michaelmargolis/MirtoDesignFiles/README.md

# MirtoDesignFiles

Design files for Mirto Robots

Mirto_Hubee robot has a Teensy3 controller driving HUBee wheels 

Mirto_Hotec has a teensy3 controller driving Hotec motors

Mirto_MyRio uses National Instruments myRIO to control Hotec Motors.
