michaelmargolis/MirtoDesignFiles/Mirto_Hotec/Multi-build dxf files/MirtoAcrylicChassis_6_off_ FullSheet.dxf

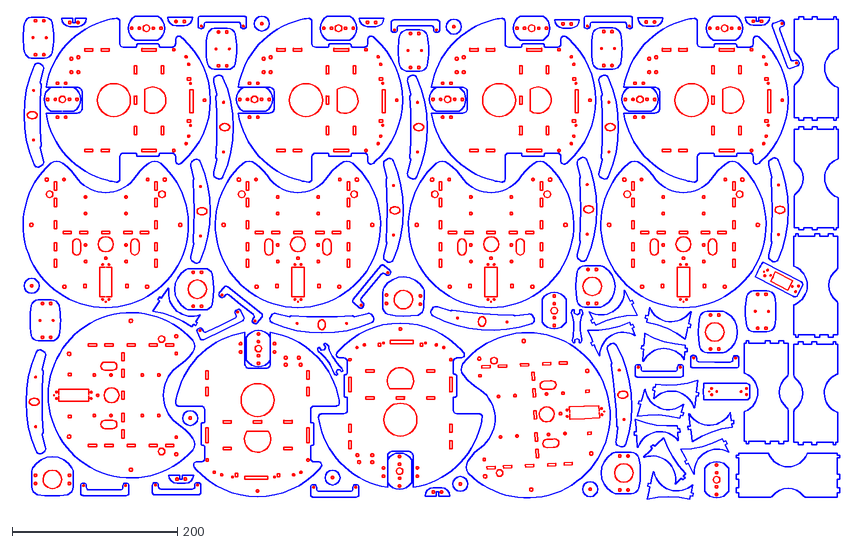
[picture p3: CAD file, 2017-03-19]
Mirto_Hotec/Multi-build dxf files/MirtoAcrylicChassis_6_off_ FullSheet.dxf
996.0 x 591.0
