michaelmargolis/MirtoDesignFiles/Mirto_MyRIO/Multi-build dxf files/MirtoMyRioAcrylicTop_15_off_ FullSheet.dxf

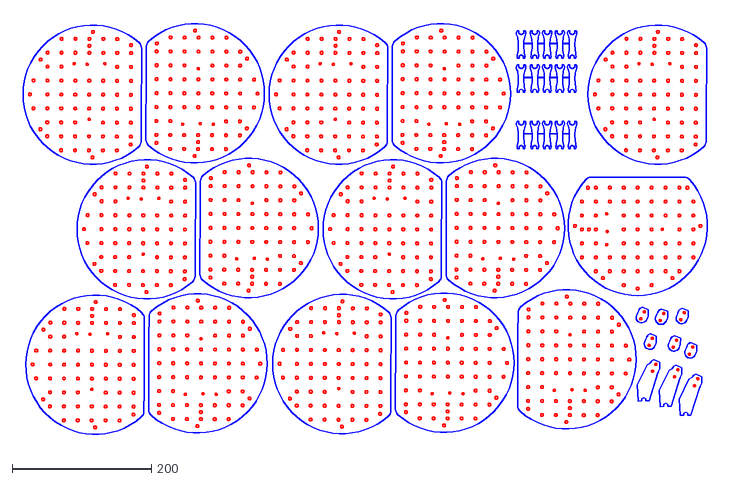
[picture p4: CAD file, 2017-03-19]
Mirto_MyRIO/Multi-build dxf files/MirtoMyRioAcrylicTop_15_off_ FullSheet.dxf
1002.3 x 610.7
