michaelmargolis/MirtoDesignFiles/Mirto_Hotec/Mirto_Acrylic_1off.dxf

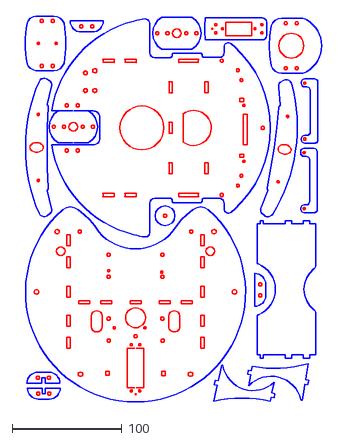
[picture p5: CAD file, 2017-03-19]
Mirto_Hotec/Mirto_Acrylic_1off.dxf
277.3 x 350.8
