michaelmargolis/MirtoDesignFiles/Mirto_Hubee/Strong Twin AngleBracket.stl

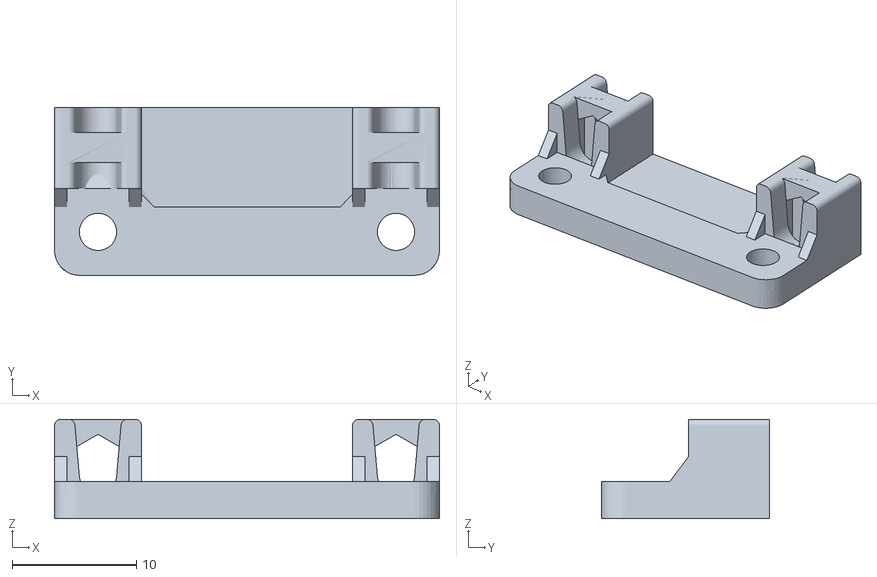
[picture p6: CAD file, 2017-03-19]
Mirto_Hubee/Strong Twin AngleBracket.stl
31.0 x 13.5 x 8.00
