michaelmargolis/MirtoDesignFiles/Mirto_MyRIO/Mirto_Aluminium_1off.dxf

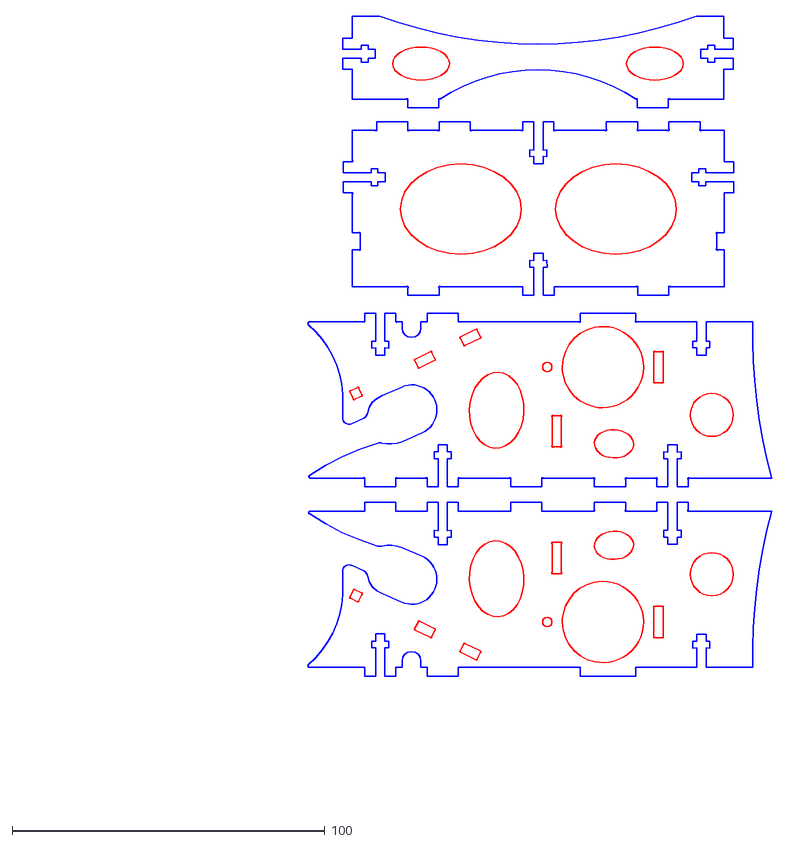
[picture p7: CAD file, 2017-03-19]
Mirto_MyRIO/Mirto_Aluminium_1off.dxf
241.7 x 252.1
