michaelmargolis/MirtoDesignFiles/Mirto_Hotec/Multi-build dxf files/mirtoAli_6off_430x430_rounded.dxf

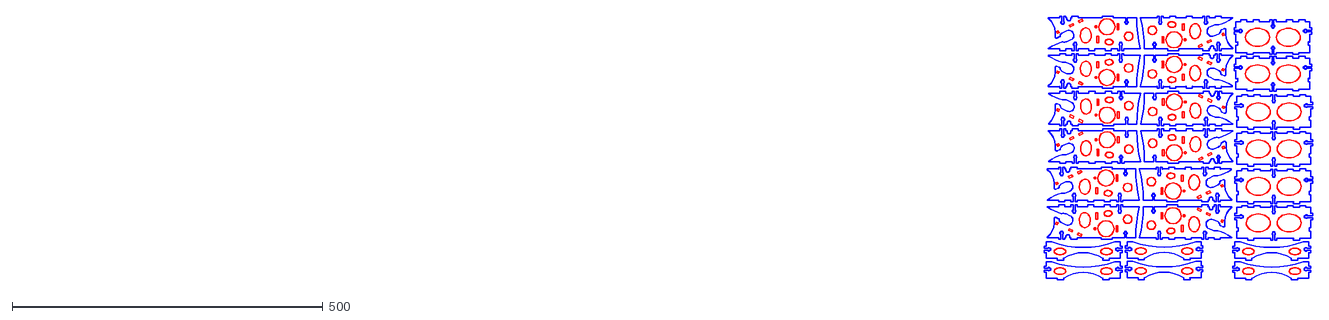
[picture p8: CAD file, 2017-03-19]
Mirto_Hotec/Multi-build dxf files/mirtoAli_6off_430x430_rounded.dxf
2084.9 x 424.5
