michaelmargolis/MirtoDesignFiles/Mirto_Hubee/Ultrasonic Clip Flat.stl

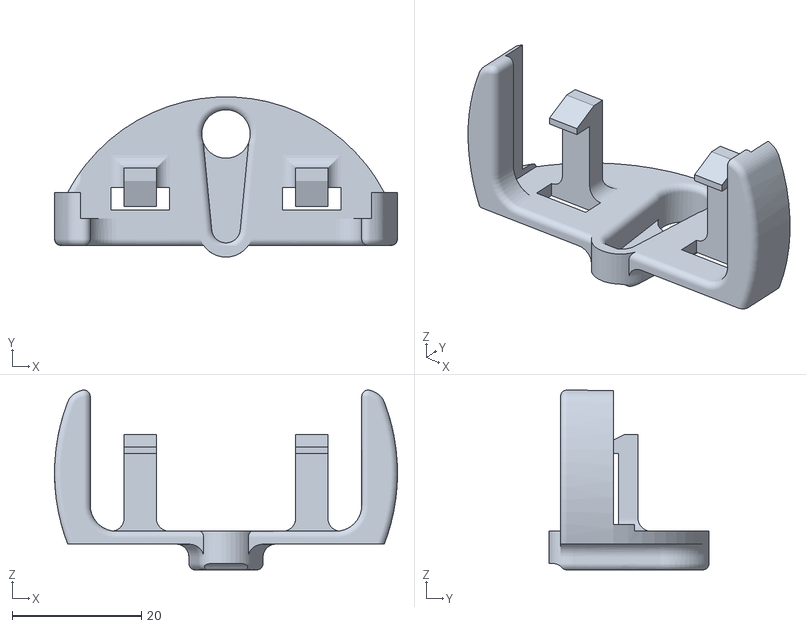
[picture p9: CAD file, 2017-03-19]
Mirto_Hubee/Ultrasonic Clip Flat.stl
53.1 x 24.8 x 27.9
