michaelmargolis/MirtoDesignFiles/Mirto_MyRIO/Mirto_Acrylic_1off.dxf

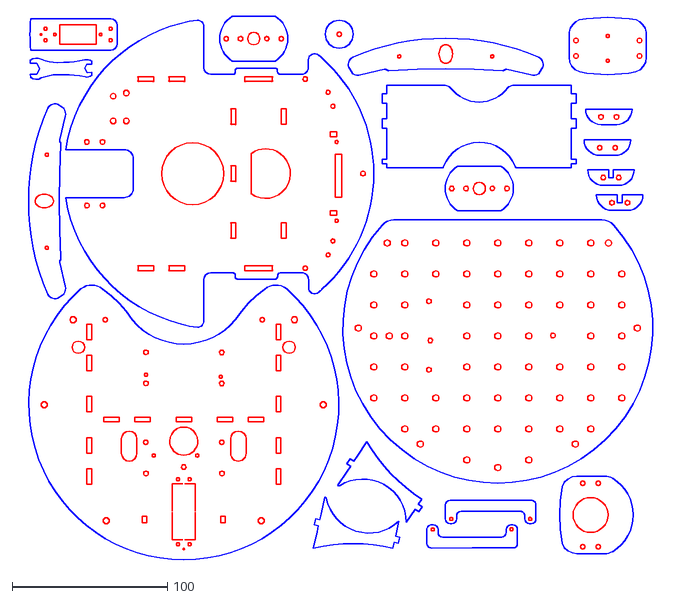
[picture p10: CAD file, 2017-03-19]
Mirto_MyRIO/Mirto_Acrylic_1off.dxf
421.3 x 350.7
