michaelmargolis/MirtoDesignFiles/Mirto_Hotec/1_3 oled bracketTiltedSnap.stl

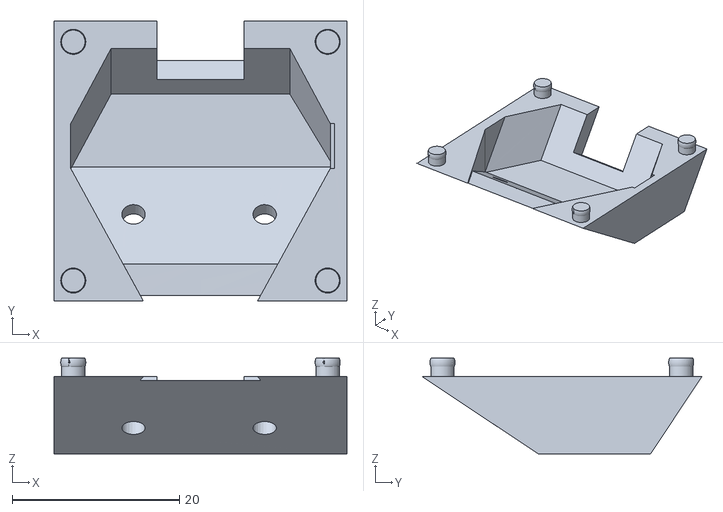
[picture p11: CAD file, 2017-03-19]
Mirto_Hotec/1_3 oled bracketTiltedSnap.stl
35.0 x 33.4 x 11.4
