michaelmargolis/MirtoDesignFiles/Mirto_Hotec/Multi-build dxf files/Mirto_Ali_3off_rounded.dxf

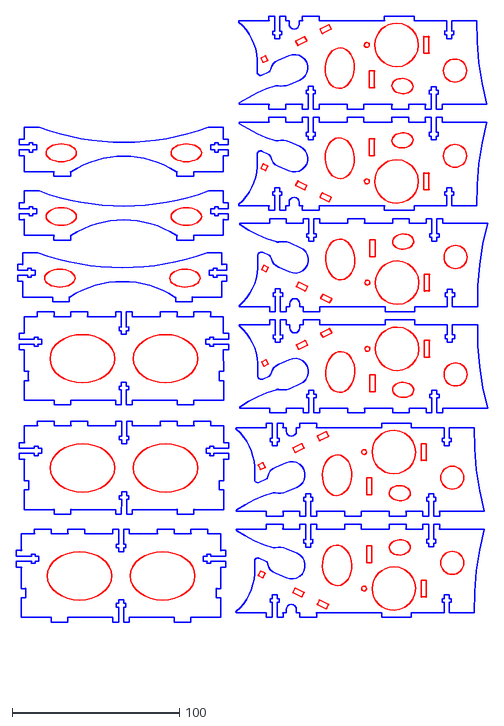
[picture p12: CAD file, 2017-03-19]
Mirto_Hotec/Multi-build dxf files/Mirto_Ali_3off_rounded.dxf
281.5 x 400.3
