michaelmargolis/MirtoDesignFiles/Mirto_MyRIO/Mirto Build for myRIO.pdf

## myRIO Robot Mechanical Build Information

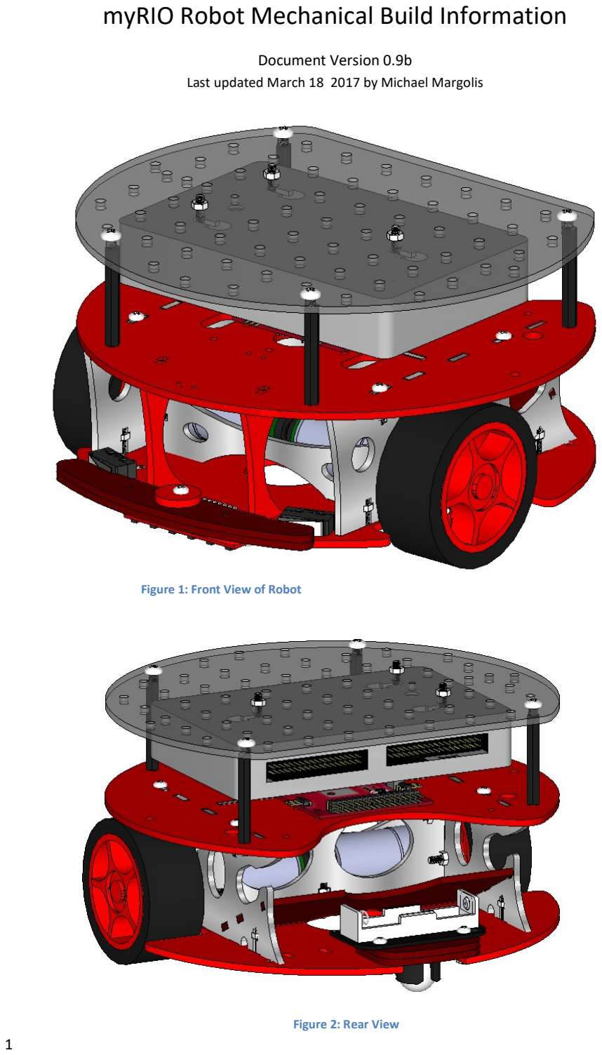
[picture p36: page 1]

1

Document Version 0.9b
Last updated March 18 2017 by Michael Margolis

Figure 2: Rear View

Figure 1: Front View of Robot

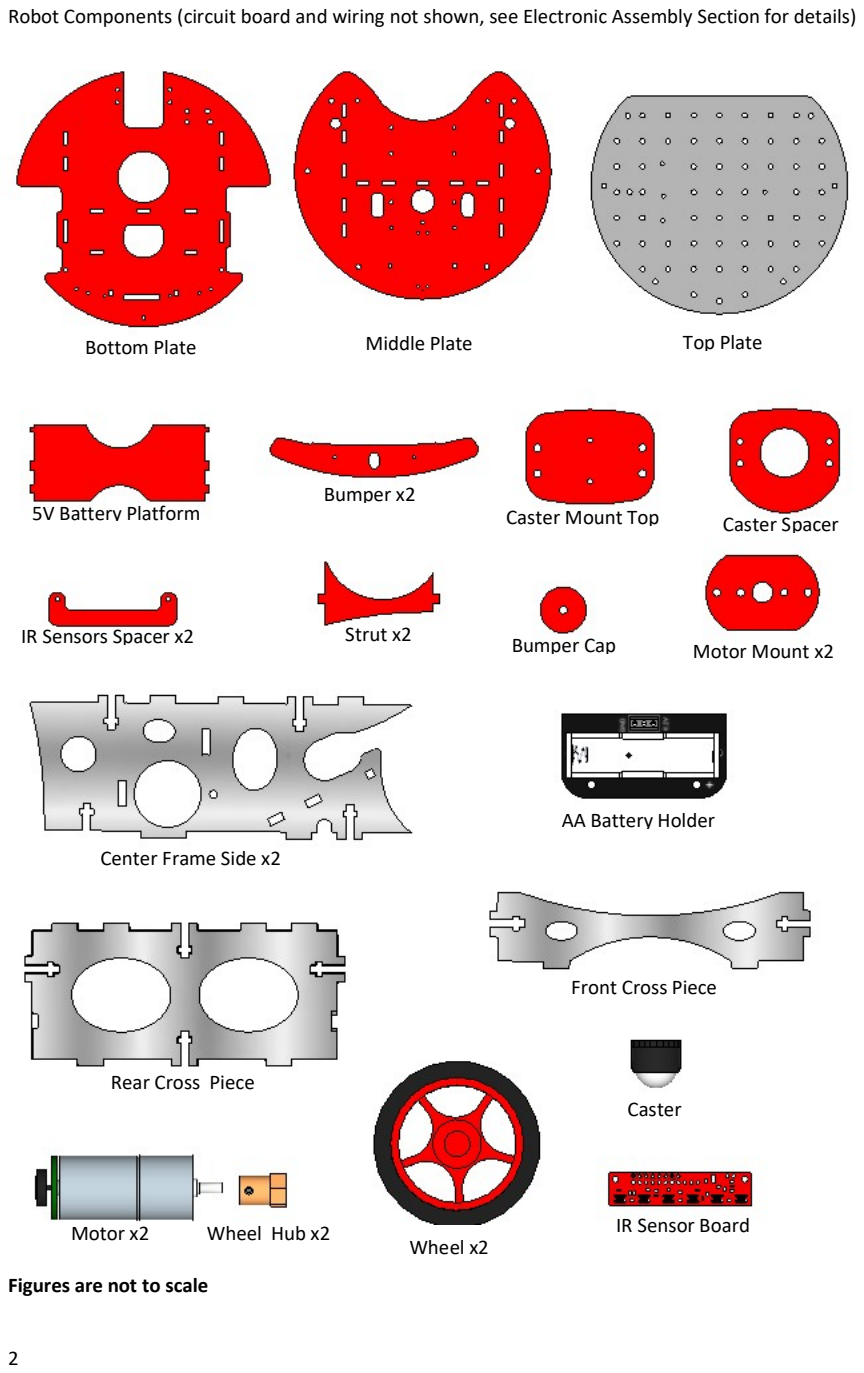
[picture p37: page 2]

2

Robot Components (circuit board and wiring not shown, see Electronic Assembly Section for details)

Figures are not to scale

Bottom Plate | Middle Plate | Top Plate

5V Battery Platform

Bumper x2
Caster Mount Top | Caster Spacer
IR Sensors Spacer x2 | Strut x2 | Bumper Cap

AA Battery Holder
Center Frame Side x2

Front Cross Piece

Rear Cross Piece

Motor Mount x2

Caster

Motor x2 | Wheel Hub x2 | IR Sensor Board
Wheel x2

3

Hardware:

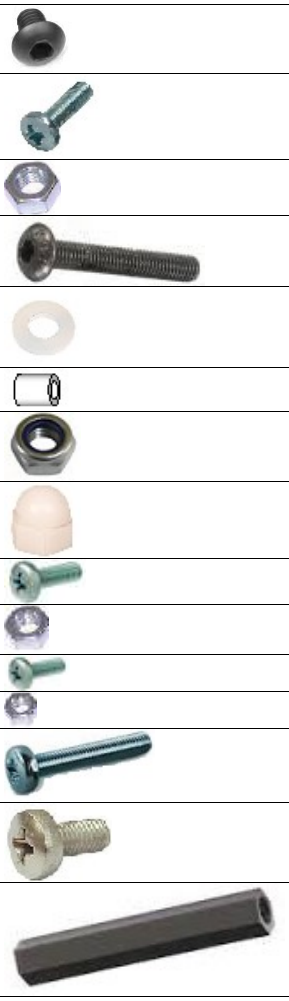
[picture p38: figure]

Quantity | Description
4 M3 x 5 socket button screw

16 M3 X 12 pan head machine screw

24 M3 nut

1 M3 X 20 socket button screw

1 Plastic washer

1 M3 X 6 spacer

1 M3 locknut

1 Nylon dome nut

8 M2.5 x 12 pan head machine screw

12 M2.5 nut

2 M2 X 12 pan head machine screw 2 M2 nut
2 M3 X 16 pan head machine screw

12 M4 X 8 pan head machine screw

4 M4 x 40 hex spacer

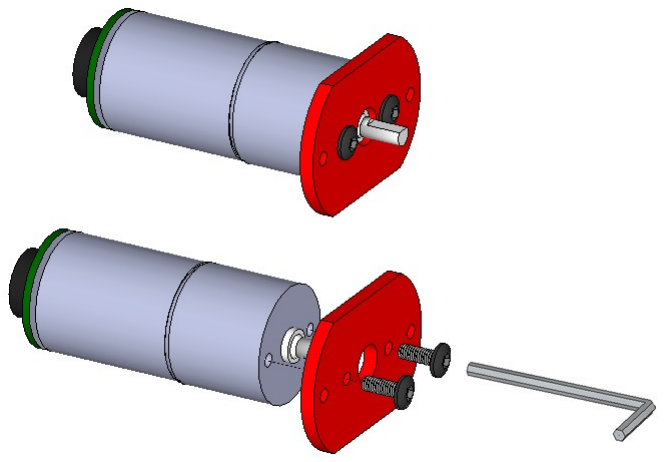
[picture p39: figure]

4

Build notes:

- Read through all steps before beginning assembly
- Double check hardware before each assembly step and make sure that the length of the screw matches the instructions.
- Look at the prototype if you are not sure how things go together
- Don’t overtighten the screws
- Machine screws are pan head where not specified.
- Use thread lock only after initial assembly

Attach motors to mount using two M3x5 socket screws. Don’t over-tighten these (hint – hold the shorter end of the hex key using only two fingers when tightening). Caution – you must use the M3x5 hardware specified, longer screws will damage the gearbox!

Hardware: 4 off M3x5 socket button screws

Figure 1: Motor Mount


5

Assemble the center frame using the two aluminium side pieces, two cross pieces and one acrylic battery platform.

Hardware:

### 2 off M3x12 pan head machine screws 4 off M3 nuts

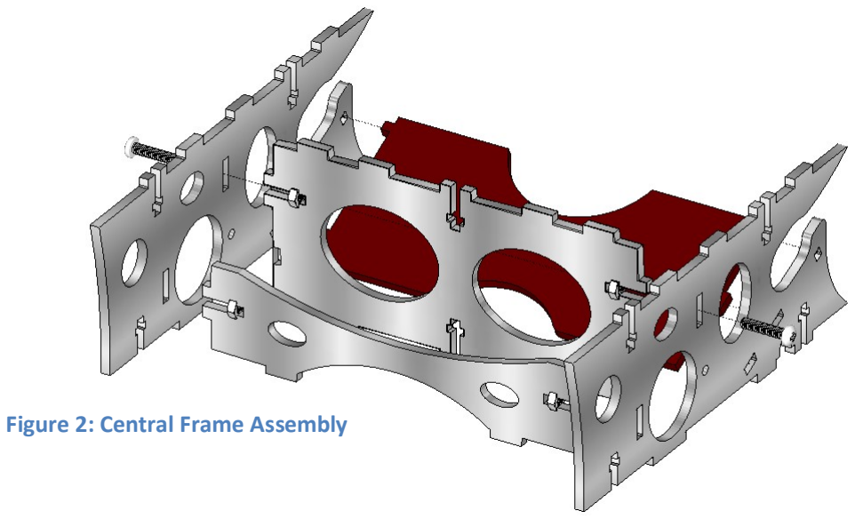
[picture p40: figure]
Figure 2: Central Frame Assembly

Four M3 nuts must be inserted into the slots on the cross pieces. The nuts are a tight fit and will only go into the slots when oriented as shown in Figure 3a. You may need to use a little force if the slot is cut slightly narrow.

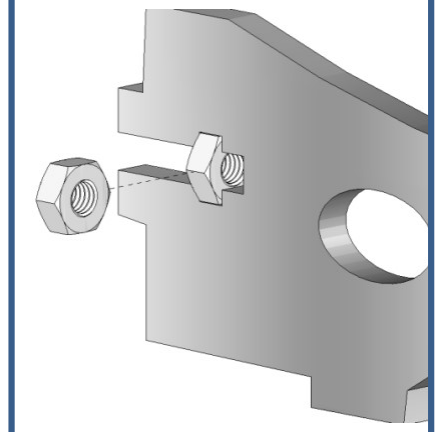
[picture p41: figure]

The screws holding the smaller cross piece will be added in the next step but it will be easier to insert the nuts now before the motors are attached. Tip: if the nuts do not stay in place you can hold them with a small piece of masking tape.

Figure 3a: M3 nut detail

Figure 3: Central Frame from above

6

Attach the motor assembly to the center frame using M3x12 machine screws. The screw holding the front (smaller) cross piece uses the nuts added in the previous step.

Hardware:

### 4 off M3x12 pan head machine screws 2 off M3 nuts

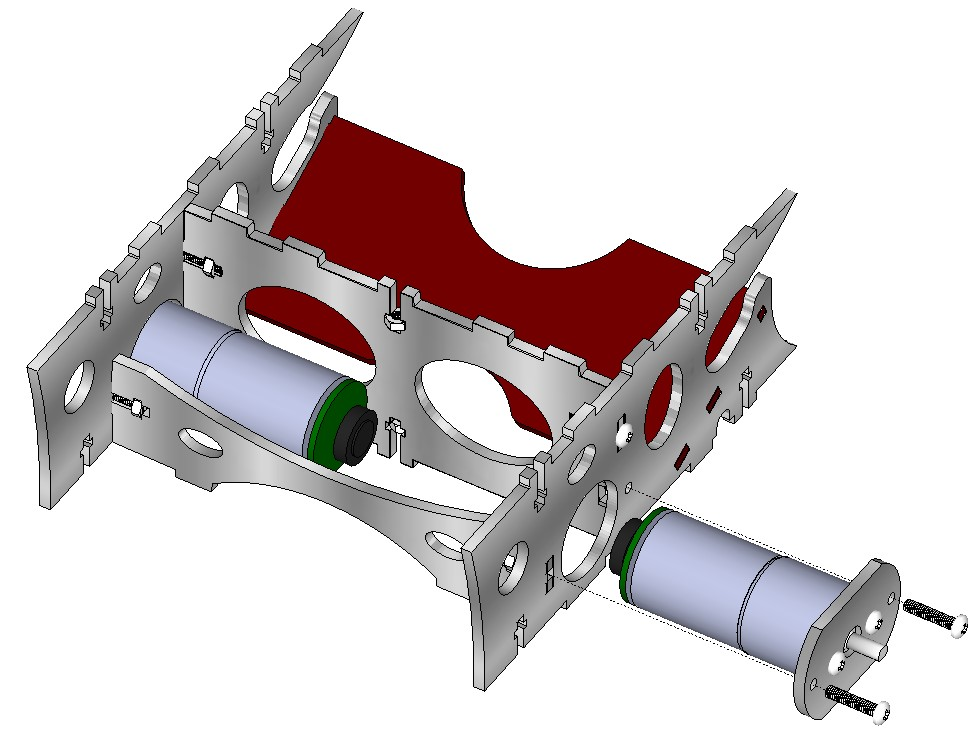
[picture p42: figure]
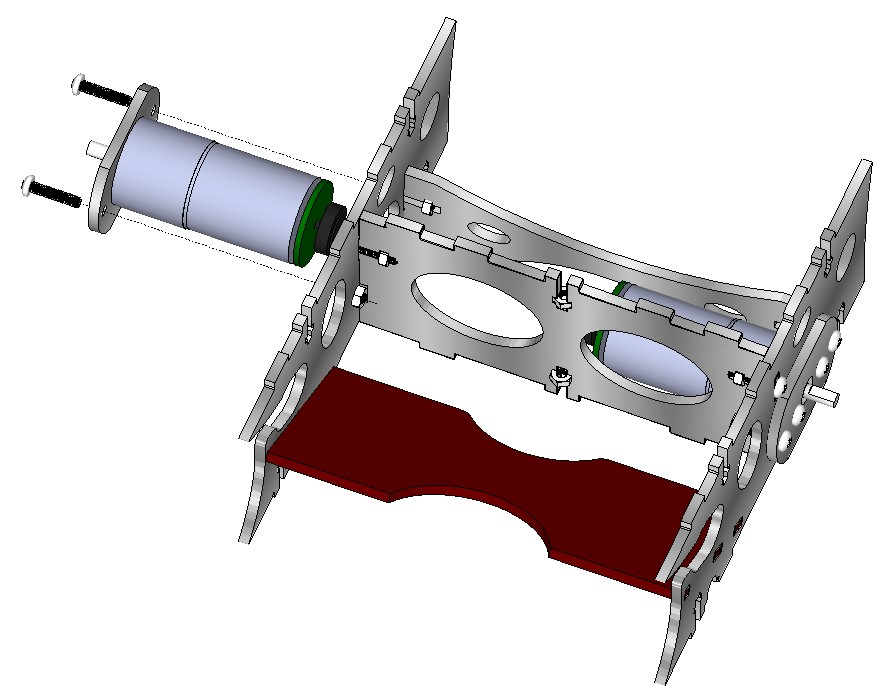
[picture p43: figure]

Figure 4: Motor Attachment to Frame

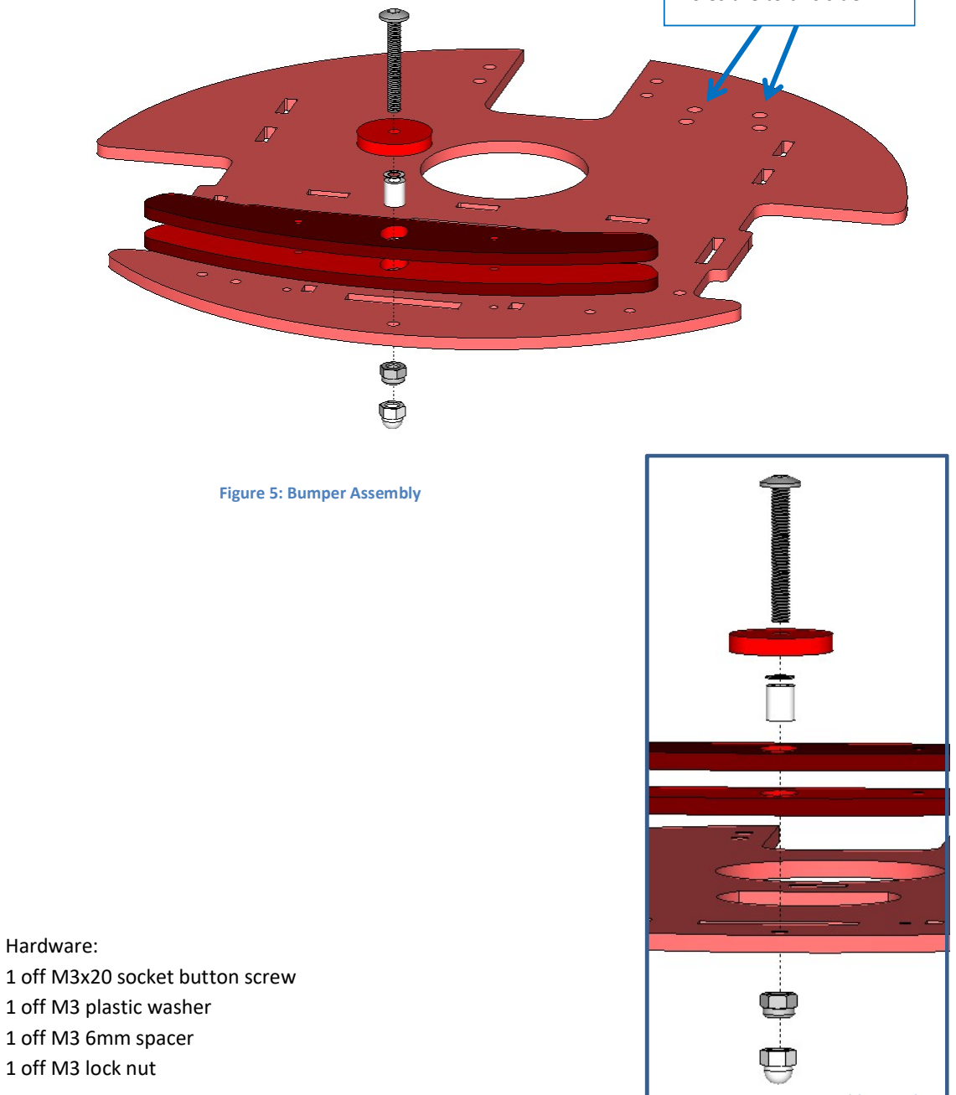
[picture p44: figure]
1 off M3x20 socket button screw 1 off M3 plastic washer 1 off M3 6mm spacer 1 off M3 lock nut; Figure 5: Bumper Assembly

7

Attach two bumpers to the lower plate using a 20mm M3 button head screw. The washer and spacer are used to enable the bumpers to be held firmly but slide easily. Variations in acrylic thickness may require a second washer or no washer at all. The lock nut is metal with a nylon insert that resists turning; you will need to hold this nut with pliers when tightening the screw with a hex key. The plastic dome nut is then screwed onto the bottom to act as a skid to prevent the robot tipping forward and damaging the IR sensors.

Hardware:

### 1 off M3 plastic dome nut

Orient plate so these
holes are to this side

Figure 6: Bumper Assembly Detail

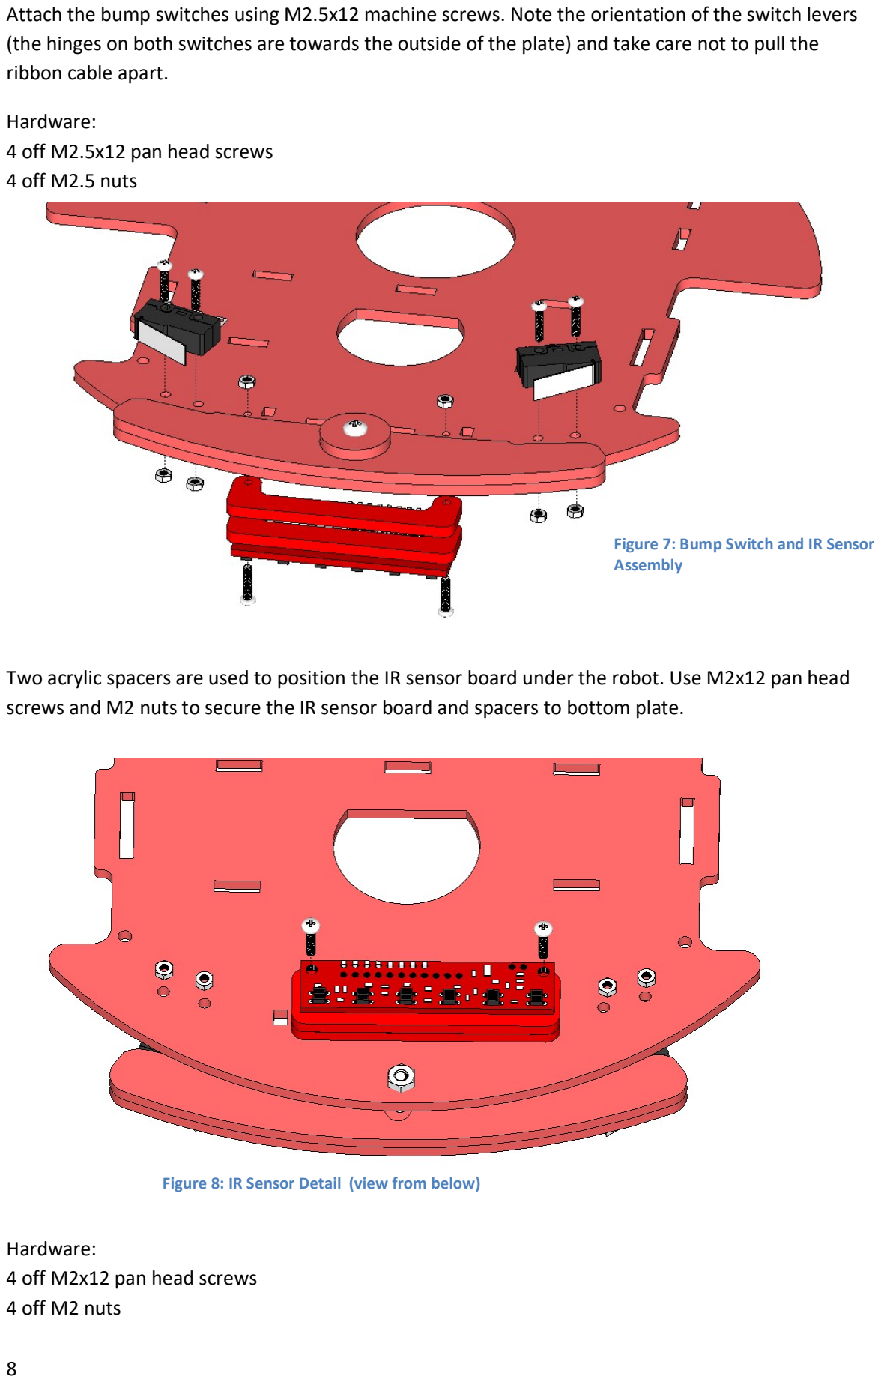
[picture p45: page 8]

8

Attach the bump switches using M2.5x12 machine screws. Note the orientation of the switch levers (the hinges on both switches are towards the outside of the plate) and take care not to pull the ribbon cable apart.

Hardware:

### 4 off M2.5x12 pan head screws 4 off M2.5 nuts

Two acrylic spacers are used to position the IR sensor board under the robot. Use M2x12 pan head screws and M2 nuts to secure the IR sensor board and spacers to bottom plate.

Hardware:

### 4 off M2x12 pan head screws 4 off M2 nuts

Figure 7: Bump Switch and IR Sensor Assembly

Figure 8: IR Sensor Detail (view from below)


9

Attach the bottom plate to the central frame using four M3x12 machine screws and nuts.

Hardware:

### 4 off M3x12 pan head screws 4 off M3 nuts

Figure 9: Attaching Bottom Plate to Frame

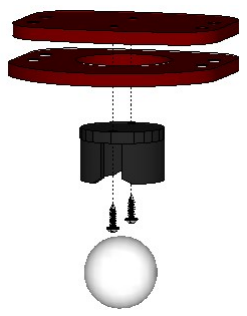
[picture p46: figure]
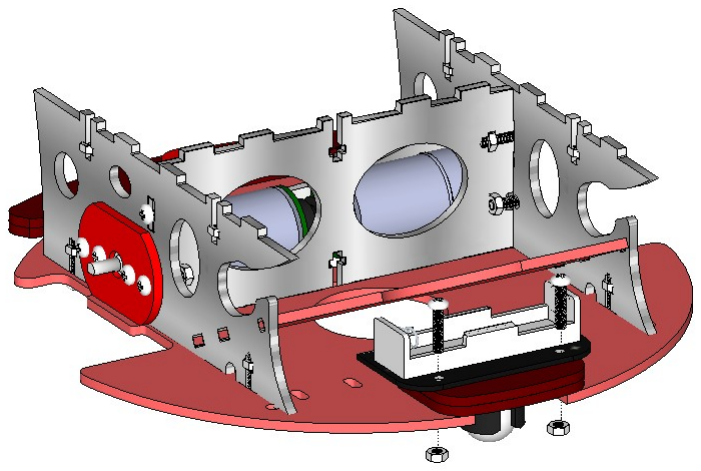
[picture p47: figure]

10

Assemble the caster mount. Remove the steel ball from the ABS caster housing and use the two small self-tapping screws supplied with the caster to secure the caster housing to the mount. Then push the ball back into the caster housing.

Hardware:

### 2 self-tapping screws supplied with caster

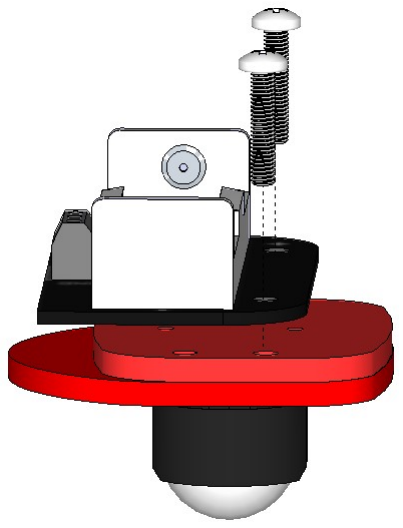
[picture p48: figure]

Attach the battery holder and caster assembly using M3x16 machine screws. The rear edges of the castor acrylic spacer and top should be flush with the curve of the bottom plate.

Hardware:

### 2 M3x16 pan head screws 2 M3 nuts

Figure 12: Caster and Battery Holder Assembly

Figure 10: Assembling the Caster

Figure 11a: Note orientation of the acrylic pieces and the battery assembly

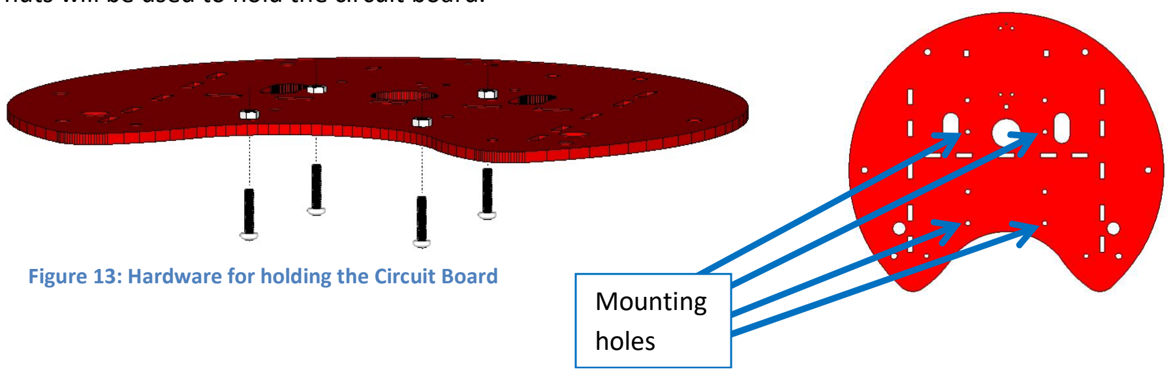
[picture p49: figure]
Mounting holes
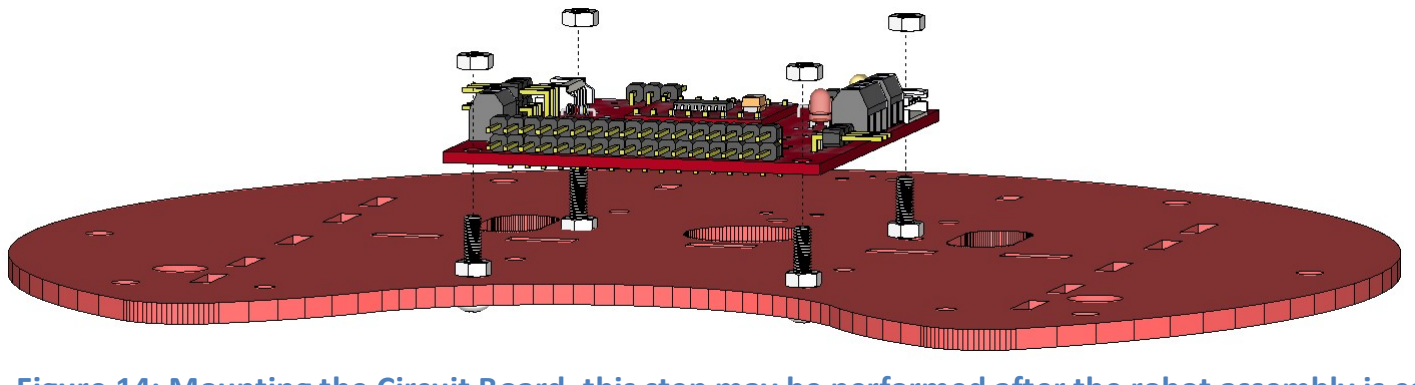
[picture p50: figure]
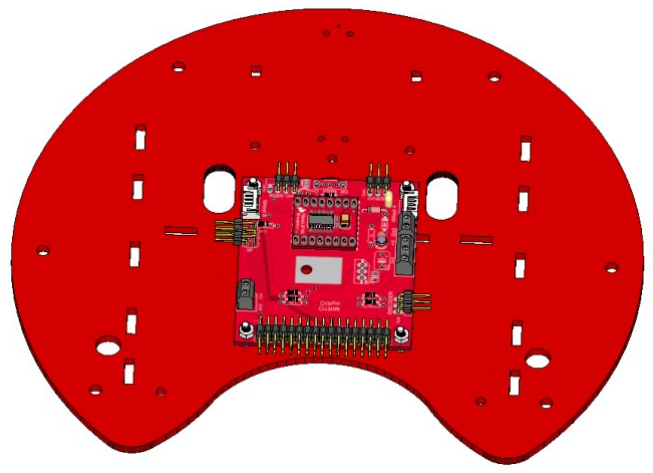
[picture p51: figure]

11

M2.5x12 Machine screws inserted from underneath the middle plate and held in place with M2.5 nuts will be used to hold the circuit board.

The hardware should be tightened so the screws protrude above the middle plate. The circuit board will be placed onto these bolts and fastened with M2.5 nuts. This method of assembly is used so the circuit board can be easily removed when the robot is fully assembled and the bottom of this plate is not easily accessible.

Hardware:

### 4 M2.5x12 pan head machine screws 8 M2.5 nuts

Figure 13: Hardware for holding the Circuit Board

Figure 14: Mounting the Circuit Board, this step may be performed after the robot assembly is completed

Figure 15: View showing location of Circuit Board

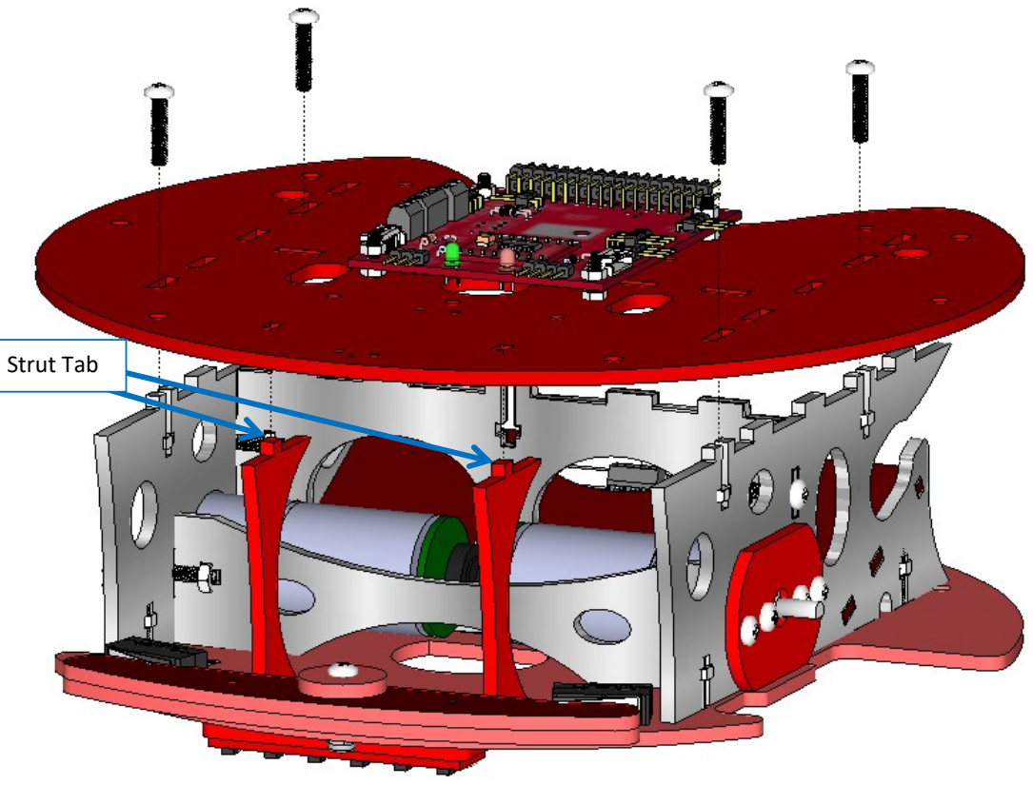
[picture p52: figure]
Strut Tab

12

Attach the middle plate to the central frame using four M3x12 machine screws. Note that the two support struts must be fitted during this step. The square tabs at the ends of the struts fit into slots on the upper and lower plates.

Hardware:

### 4 off M3x12 pan head screws

### 4 off M3 nuts

Figure 16: Attaching the Middle Plate and Support Struts

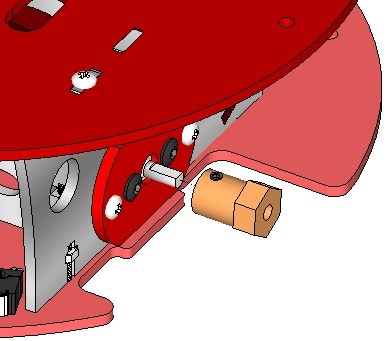
[picture p53: figure]
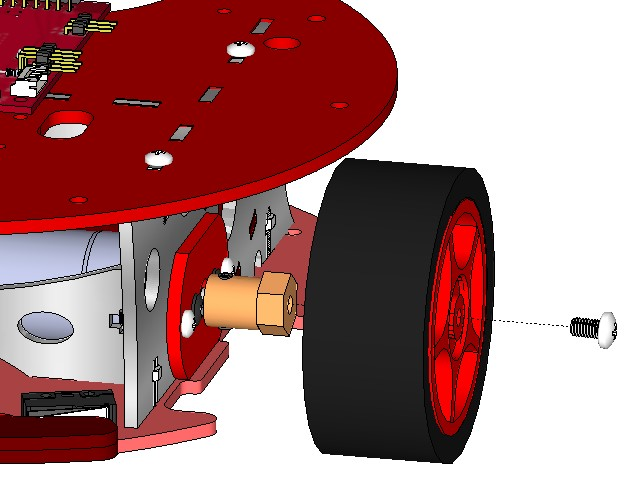
[picture p54: figure]

13

Attach the 12mm hex wheel hub adapters to the motor shafts using a hex key on the grub screws. You may need to loosen the grub screws to fit onto the shaft. One grub screw should be aligned with the flat on the shaft. It is important that the hub is not rubbing against the motor mounting screws; the gap can be paper thin.

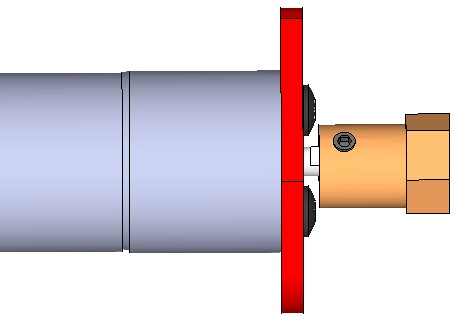
[picture p55: figure]

Push wheels onto the hubs and secure with M4 pan head screws.

Hardware:

### 2 off M4x8 pan head machine screws

Figure 18: Attach Brass Hub to Motor Shaft

Figure 17: Detail showing Hub Mounted on motor

Figure 19: Attaching Wheel to Hub

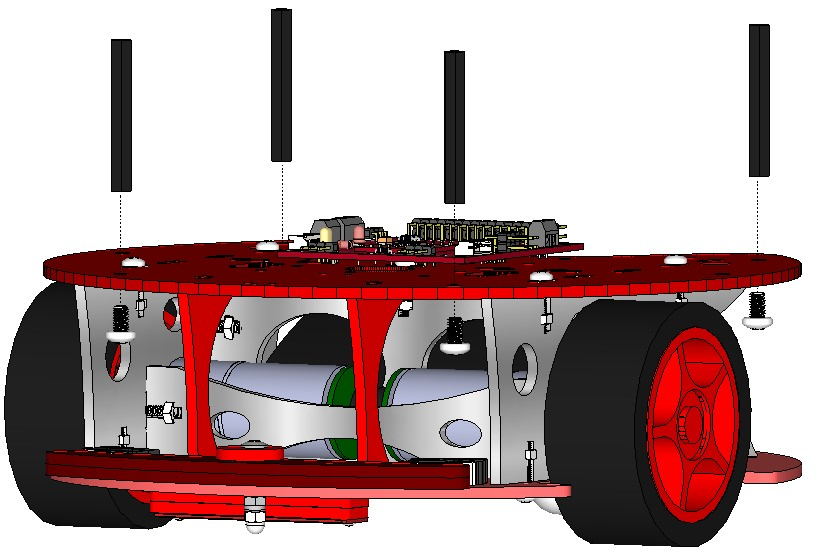
[picture p56: figure]

14

Attach four M4 support pillars to the middle plate using M4 machine screws.

Hardware:

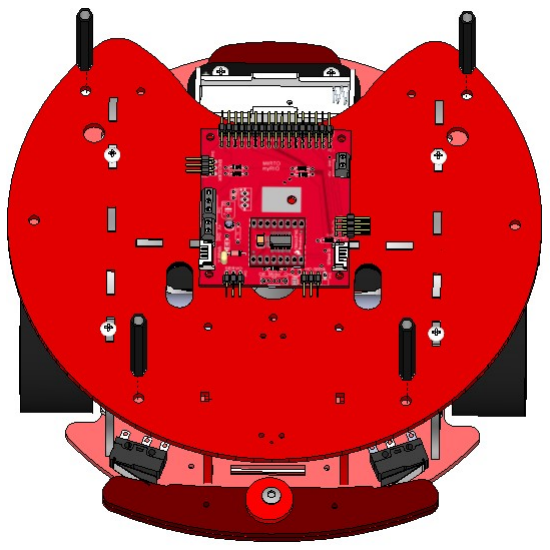
[picture p57: figure]

### 4 off M4x40 hex standoff pillars 4 off M4x8 pan head machine screws

Figure 20: Attaching Support Pillars for Top Plate

Figure 21: View Showing Pillar Location

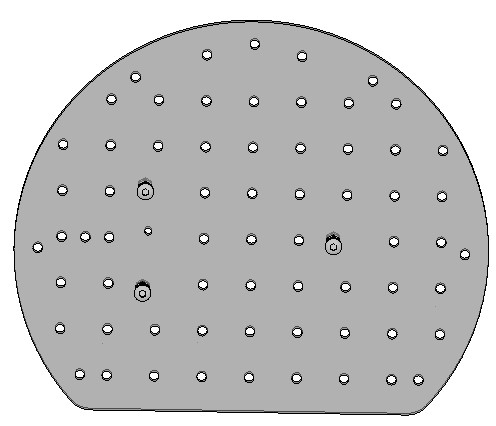
[picture p58: figure]

15

Carefully locate the three holes with the help of this figure. Ii you don’t use the correct holes, the myRIO will not attach. Assemble the mounting studs that hold the myRIO board using M3x12 button head screws. These will slide into slots on myRIO (see the next step). The space between the head and nut should be 2.5mm (slightly less space is better than more). Tighten the nuts to prevent them coming loose.

Hardware:

### 3 off M3x12 socket button screw 6 off M3 nut

Figure 22: Location for myRIO mounting

Figure 23: Side View of Mounting Hardware

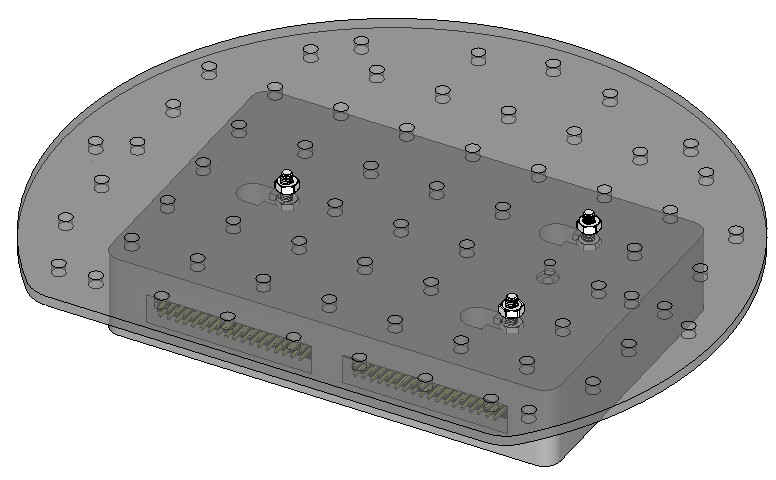
[picture p59: figure]

16

Clip MyRio onto the upper plate.

Figure 25: myRIO Side View

Figure 24: myRIO clipped to upper plate

17

If the circuit board is already attached, this is a good time to wire everything together, see the next section for wiring details. The upper plate can then be attached to the standoffs with four M4x8 machine screws.

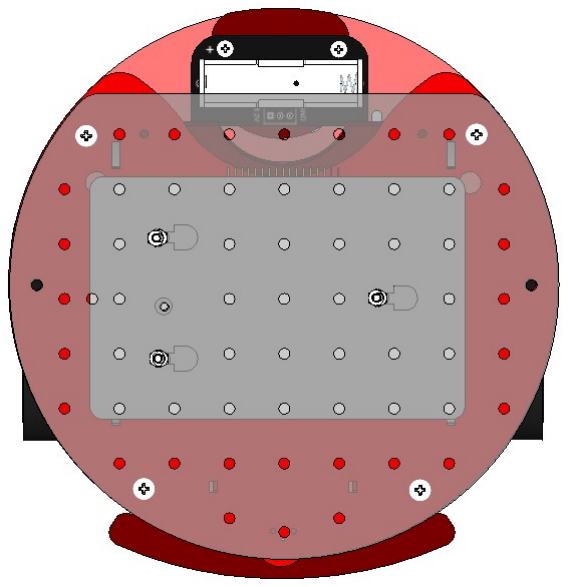
[picture p60: figure]

Hardware:

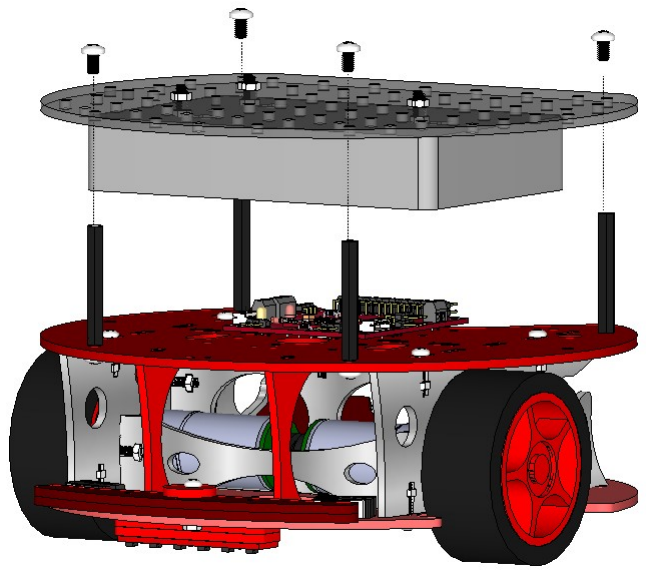
[picture p61: figure]

### 4 off M4x8 pan head machine screw

Figure 26: Upper Plate Attachment

Figure 27: Location of Mounting Screws for Upper Plate

18

### Electronic Assembly and Wiring Information

The IR Sensor Connector Board is made by soldering the eight pin header inserted from underneath, then solder the six pin header to the top. The IR sensors are connected to the main circuit board using a 6 conductor IDC cable.

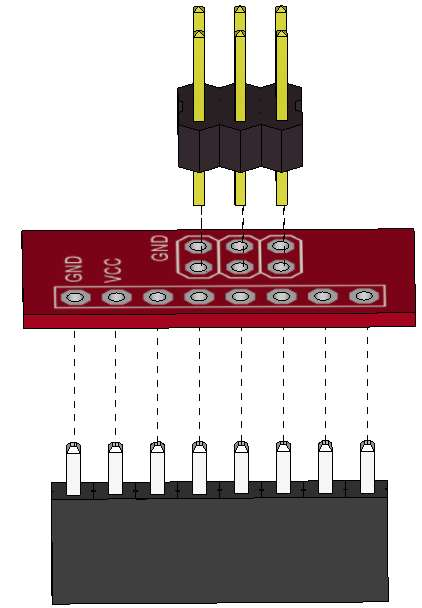
[picture p62: figure]
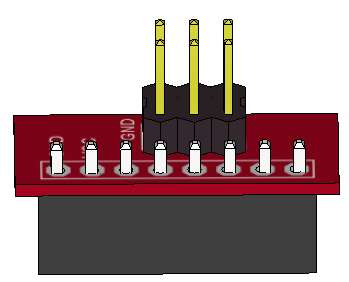
[picture p63: figure]

The bump switch assembly is made by soldering 20 cm of four conductor ribbon cable to the switches as shown. Strip 5mm of the other end of the cable and tin the ends so they can be easily attached to the terminal block on the circuit board.

Figure 28: IR Sensor Connector Board

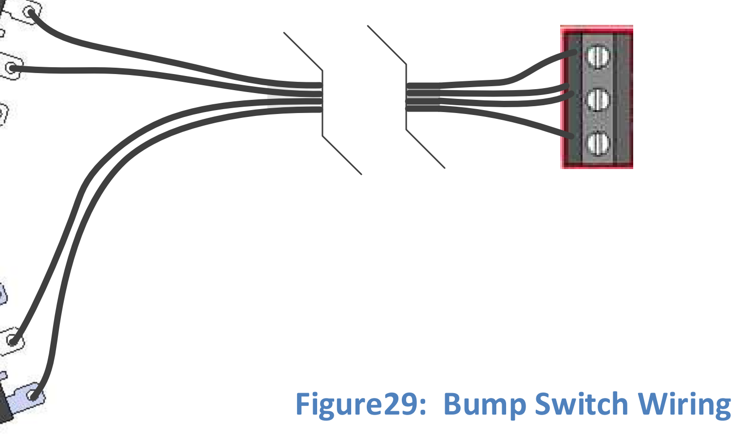
[picture p64: figure]
Figure29: Bump Switch Wiring

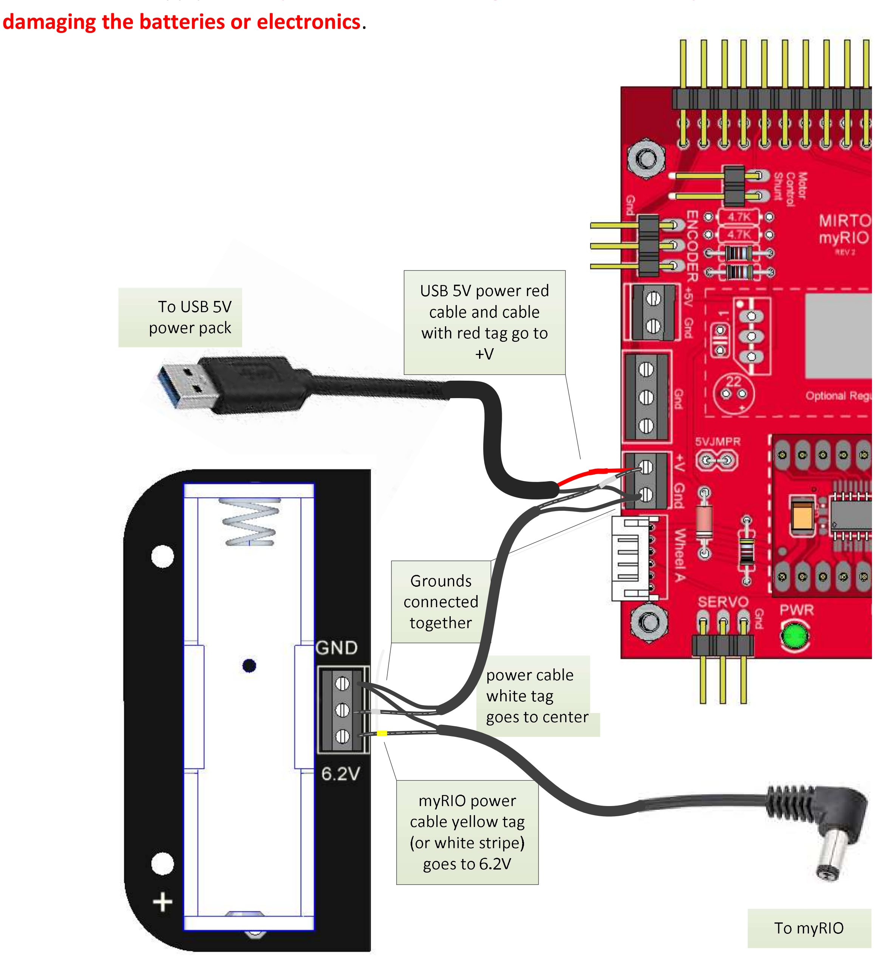
[picture p65: figure]
damaging the batteries or electronics.

19

The power connections provide 5 volts to the motor board and 6.2 volts to myRIO. Five volts is provided by a USB power pack, 6.2 volts is obtained by connecting a 1.2 volt AA battery in series with the 5 volt supply. It is important that the wiring is connected exactly as shown here to avoid

Figure 29: Wiring Power Cables

Figure 31: Power Cable Schematic

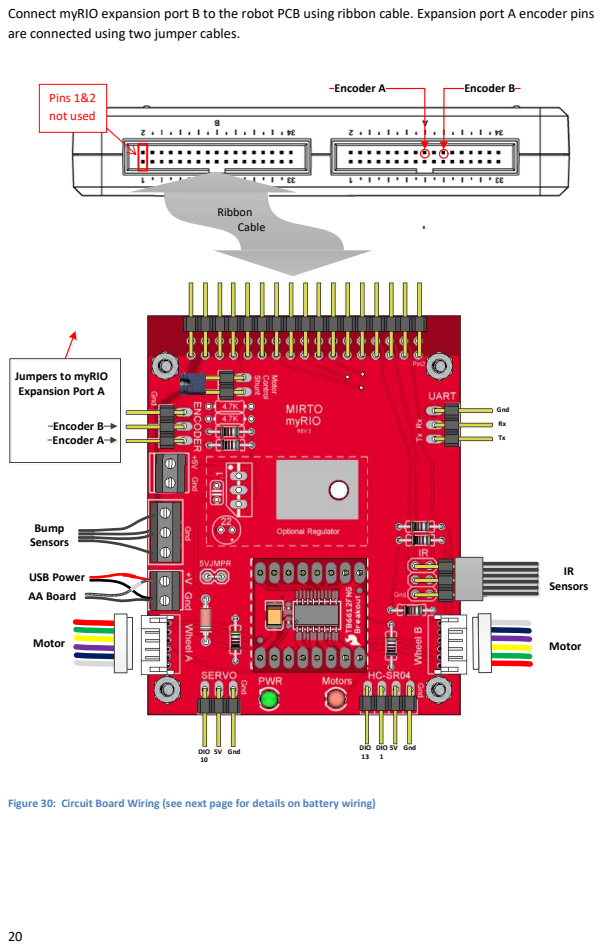
[picture p66: page 20]
Encoder A; Encoder B; IR Sensors; Bump Sensors; Motor; USB Power; Ribbon Cable; DIO; 13 DIO 1; 5V Gnd DIO 10; 5V Gnd; Pins 1&2 not used

Connect myRIO expansion port B to the robot PCB using ribbon cable. Expansion port A encoder pins
are connected using two jumper cables.

Jumpers to myRIO
Expansion Port A

TxRx Gnd AA Board
Encoder B
Encoder A

Figure 30: Circuit Board Wiring (see next page for details on battery wiring)

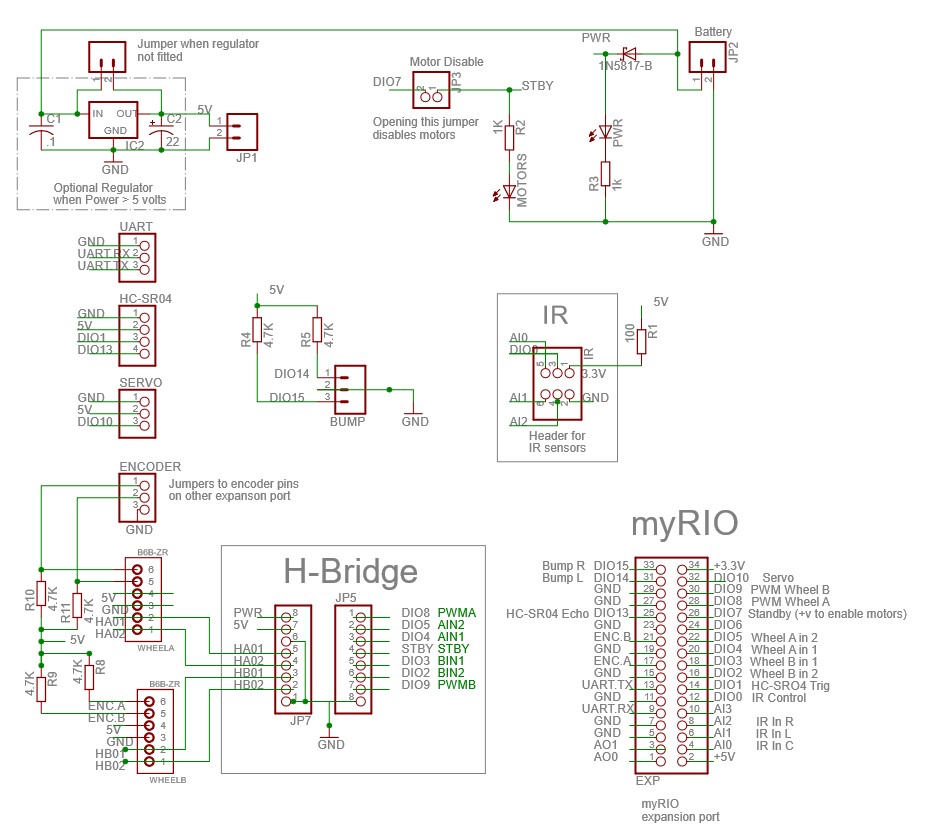
[picture p67: figure]

21

### Circuit board Schematic

Figure 31: Schematic Diagram

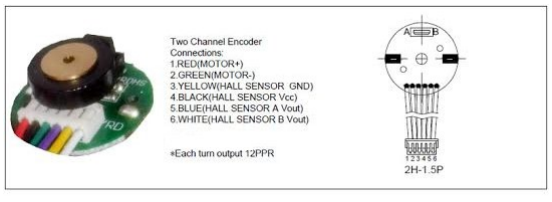
[picture p68: figure]

22

Motor Details

The specifications for the motors measured at 6 volts are as follows:

NO LOAD:
Current: < 0.15 Amps Max
Speed: 197±10%rpm

ON LOAD :
Torque: 0.7kg.cm
Current: < 0.54A Max
Speed: 158±10%rpm

STALL:
Current: < 2.87 Amps
Torque 4kg.cm

Gearbox Ratio 1:34
Maximum Motor Drive Voltage: 8.4 Volts
