michaelmargolis/MirtoDesignFiles/Hotec_H-Bridge/Hotec_H-Bridge_schematic.pdf

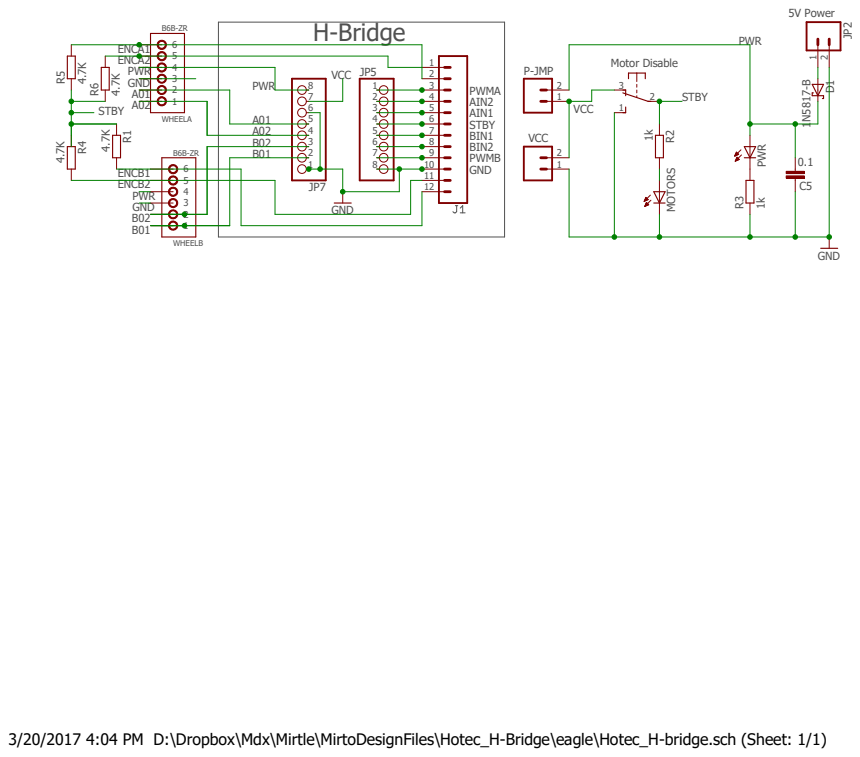
[picture p69: page 1]
H-Bridge; Motor Disable; 5V Power 1k 1k; GND; 0.1¹N⁵⁸¹⁷⁻B; GND ⁴.7K 4.7K; 2 JP2 PWR R3; 3 MOTORS R²; VCC; P-JMP R¹ R⁴ R⁵; 6 WHEELA; 6 WHEELB; STBY; PWR; PWMA; PWMB; AIN1; ENCA2; ENCB2; AIN2; ENCB1; BIN1; ENCA1; BIN2

3/20/2017 4:04 PM D:\Dropbox\Mdx\Mirtle\MirtoDesignFiles\Hotec_H-Bridge\eagle\Hotec_H-bridge.sch (Sheet: 1/1)
