michaelmargolis/MirtoDesignFiles/Mirto_Hubee/Mirto PCB 2015 Assembly Notes.pdf

# Mirto 2015 build notes

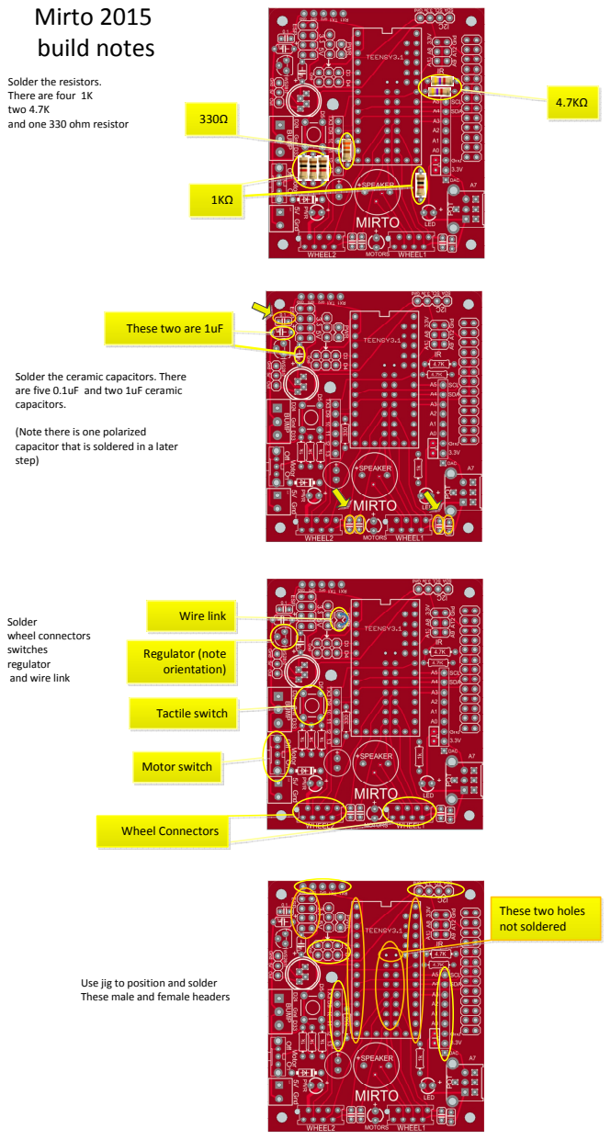
[picture p70: page 1]
Wire link; Tactile switch; Motor switch; Wheel Connectors; Regulator (note orientation)

Solder the resistors.
There are four 1K
two 4.7K
and one 330 ohm resistor

These two are 1uF

Solder the ceramic capacitors. There
are five 0.1uF and two 1uF ceramic
capacitors.

(Note there is one polarized
capacitor that is soldered in a later
step)

Solder
wheel connectors
switches
regulator
and wire link

These two holes
not soldered

Use jig to position and solder
These male and female headers

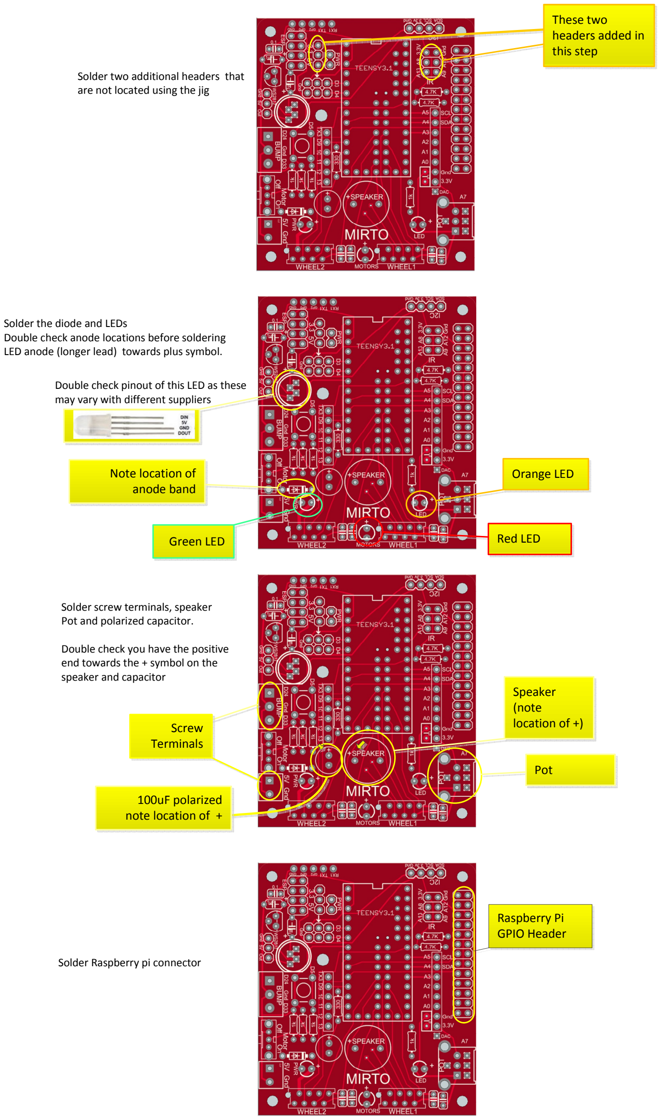
[picture p71: page 2]

Solder screw terminals, speaker Pot and polarized capacitor.

Double check you have the positive end towards the + symbol on the speaker and capacitor

Solder Raspberry pi connector

Solder the diode and LEDs
Double check anode locations before soldering LED anode (longer lead) towards plus symbol.

Solder two additional headers that are not located using the jig

Double check pinout of this LED as these may vary with different suppliers

Screw
Terminals

Raspberry Pi
GPIO Header

Pot

Speaker
(note
location of +)

Note location of
anode band
Green LED | Red LED Orange LED

100uF polarized
note location of +

These two
headers added in
this step

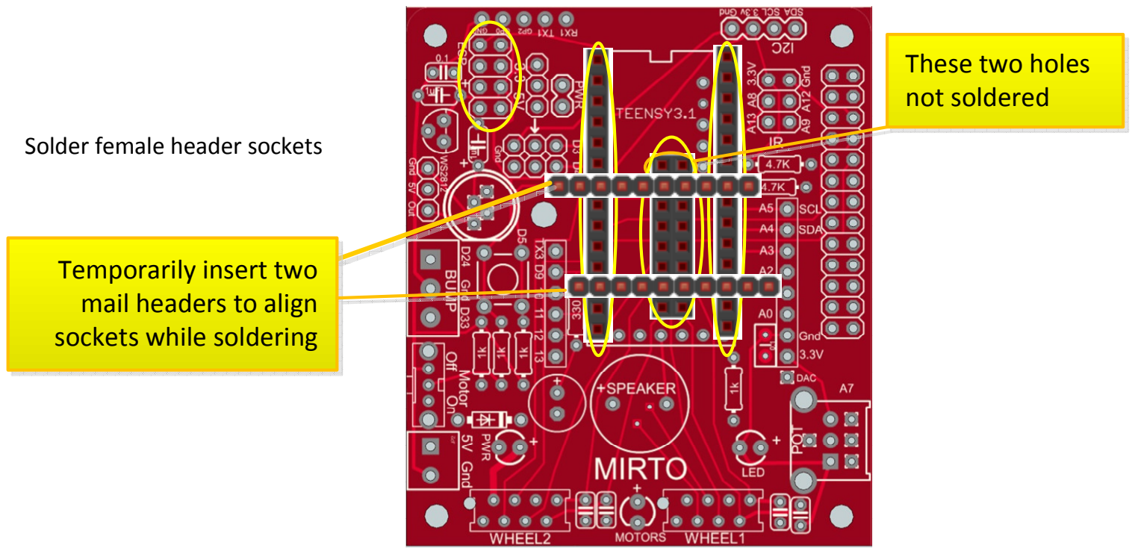
[picture p72: figure]
Solder female header sockets; These two holes not soldered; Temporarily insert two mail headers to align sockets while soldering
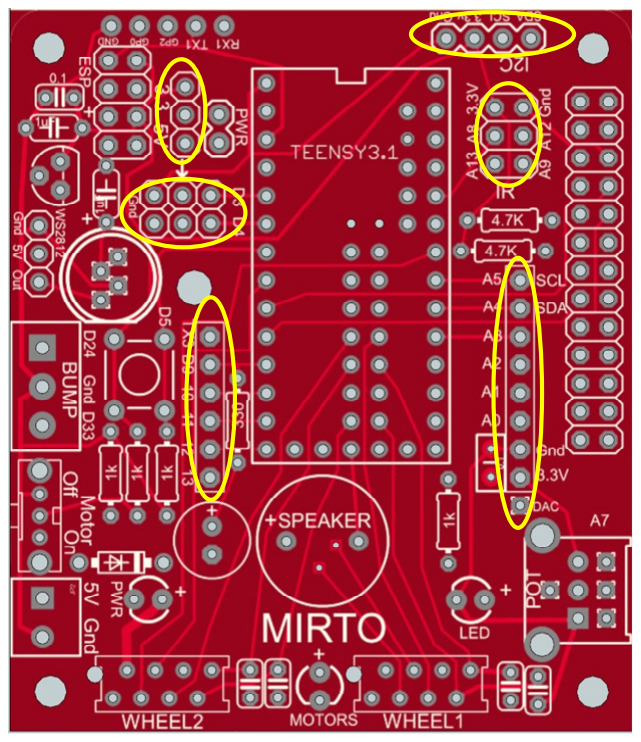
[picture p73: figure]

Solder male headers.

## Functionality:

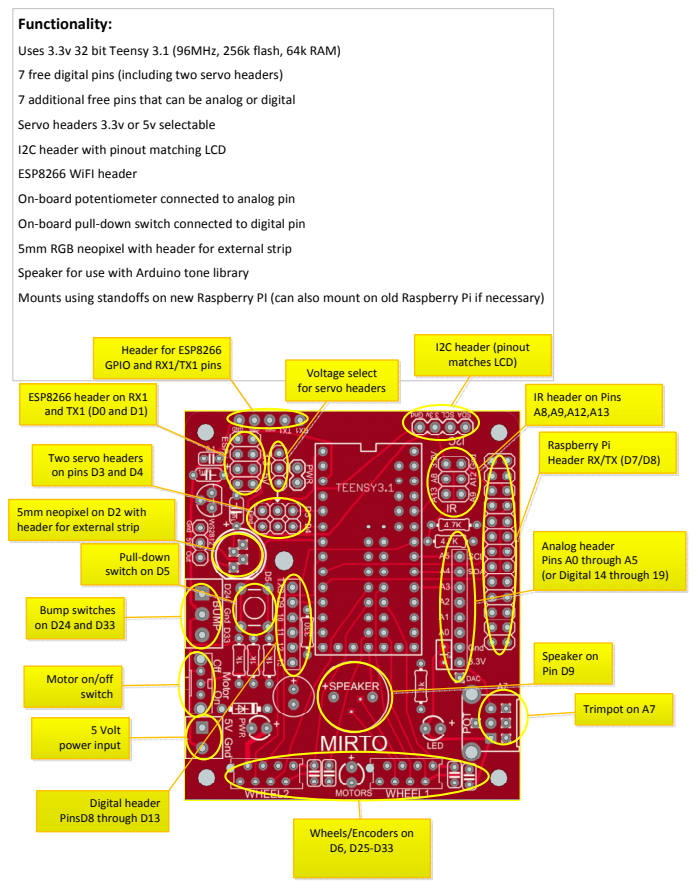
[picture p74: page 4]

Uses 3.3v 32 bit Teensy 3.1 (96MHz, 256k flash, 64k RAM)

7 free digital pins (including two servo headers)

7 additional free pins that can be analog or digital

Servo headers 3.3v or 5v selectable

I2C header with pinout matching LCD

On-board potentiometer connected to analog pin

On-board pull-down switch connected to digital pin

5mm RGB neopixel with header for external strip

Speaker for use with Arduino tone library

Mounts using standoffs on new Raspberry PI (can also mount on old Raspberry Pi if necessary)

IR header on Pins

5mm neopixel on D2 with
header for external strip

Bump switches on D24 and D33

Speaker on Pin D9
