michaelmargolis/MirtoDesignFiles/Hotec_H-Bridge/PCB information.pdf

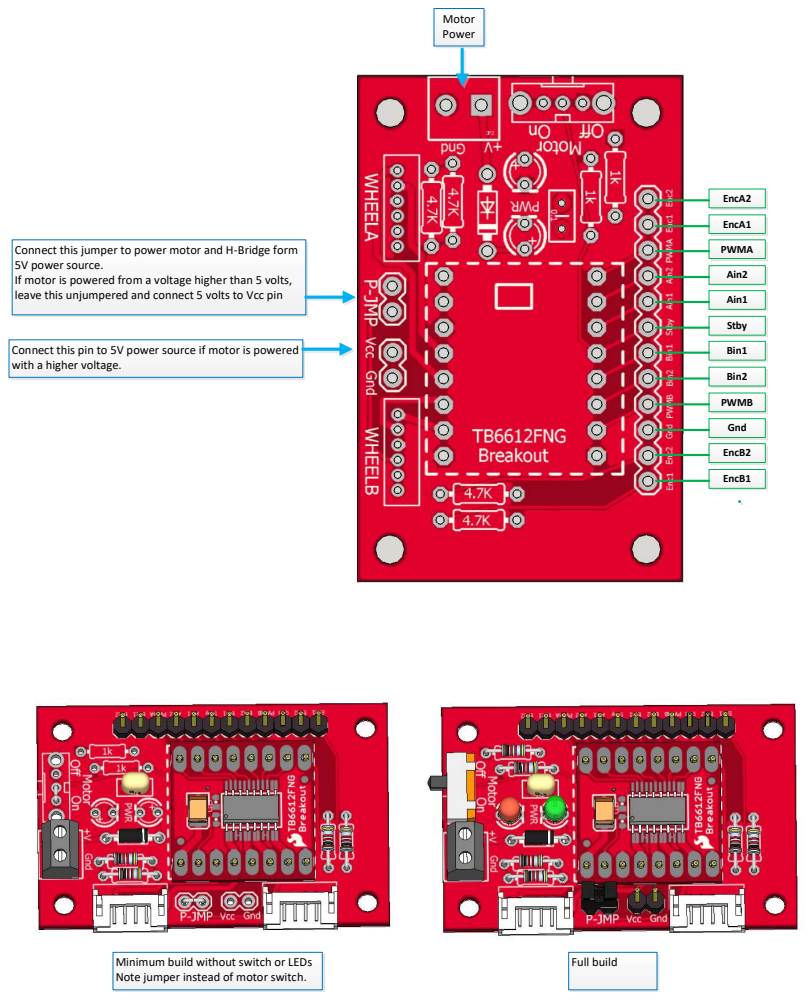
[picture p75: page 1]
EncB1; EncB2; Gnd; PWMB; Bin2; Bin1; Stby; Ain1; Ain2; PWMA; EncA1; EncA2; Motor Power; Full build

Connect this jumper to power motor and H-Bridge form
5V power source.
If motor is powered from a voltage higher than 5 volts,
leave this unjumpered and connect 5 volts to Vcc pin

Connect this pin to 5V power source if motor is powered
with a higher voltage.

Minimum build without switch or LEDs
Note jumper instead of motor switch.

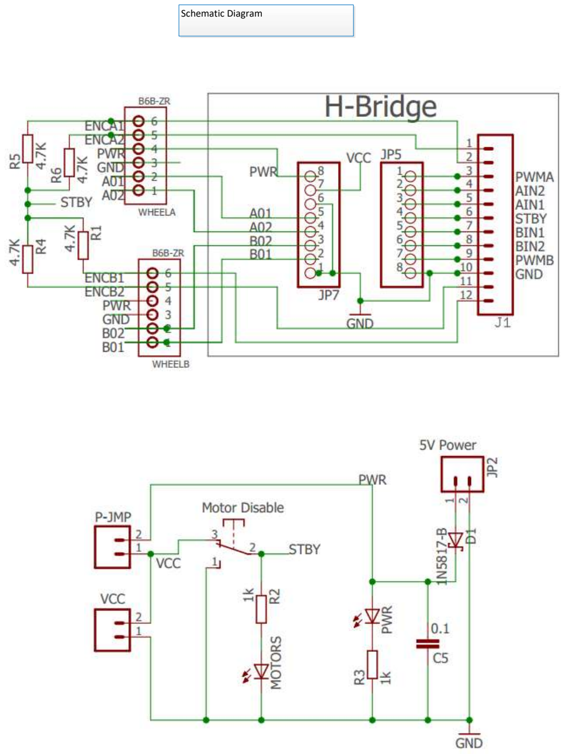
[picture p76: page 2]

Schematic Diagram
