michaelmargolis/MirtoDesignFiles/Hotec_H-Bridge/eagle/Hotec_H-bridge.brd

## EAGLE design Hotec_H-Bridge/eagle/Hotec_H-bridge.brd (2017-03-20)

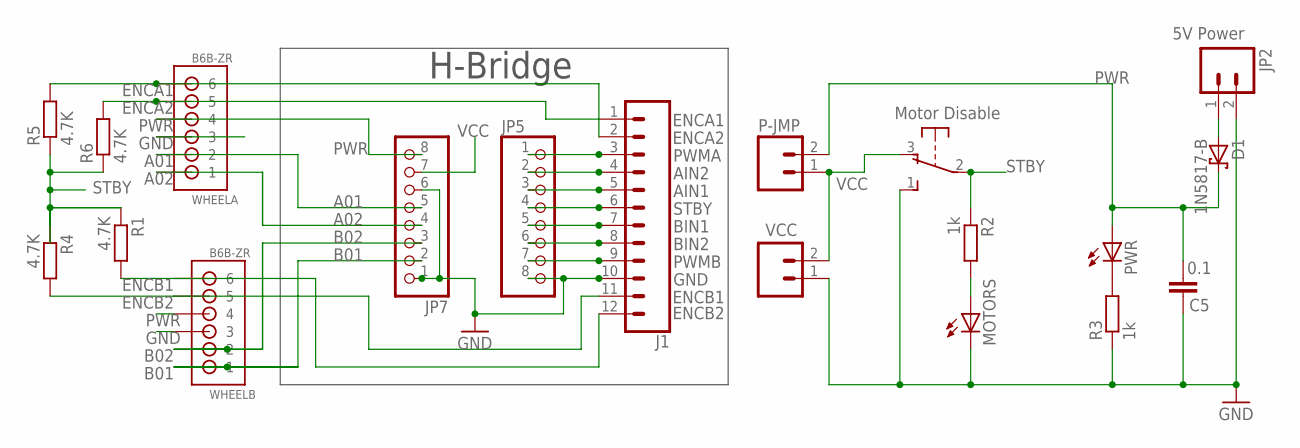
[picture p77: schematic Hotec_H-bridge.sch]

Parts:
C5: 0.1; CAP-PTH-SMALLEZ
D1: 1N5817-B; DO41-7.6
J1: CONN_12; 1X12
JP2: M023.5MM; SCREWTERMINAL-3.5MM-2
JP5, JP7: PINHD-1X8CLEANBIG; 1X08-CLEANBIG
MOTORS: LED3MM
P-JMP: M02PTH; 1X02
PWR: LED3MM
R1, R4, R5, R6: 4.7K; 0204/7
R2, R3: 1k; 0204/7
SW1: OS102011MA1Q
VCC: M02PTH; 1X02
WHEELA: B6B-ZR
WHEELB: B6B-ZR

Connections:
A01: JP7.5, WHEELA.2
A02: JP7.4, WHEELA.1
AIN1: J1.5, JP5.3
AIN2: J1.4, JP5.2
B01: JP7.2, WHEELB.1
B02: JP7.3, WHEELB.2
BIN1: J1.7, JP5.5
BIN2: J1.8, JP5.6
ENCA1: J1.2, R5.2, WHEELA.6
ENCA2: J1.1, R6.2, WHEELA.5
ENCB1: J1.12, R1.2, WHEELB.6
ENCB2: J1.11, R4.2, WHEELB.5
GND: C5.1, J1.10, JP2.2, JP5.8, JP7.1, JP7.6, MOTORS.K (C), R3.1, SW1.1 (S), VCC.1, WHEELA.3, WHEELB.3
unnamed: PWR.K (C), R3.2
unnamed: MOTORS.A, R2.2
unnamed: D1.A, JP2.1
PWMA: J1.3, JP5.1
PWMB: J1.9, JP5.7
PWR: C5.2, D1.C, JP7.8, P-JMP.2, PWR.A, WHEELA.4, WHEELB.4
STBY: J1.6, JP5.4, R1.1, R2.1, R4.1, R5.1, R6.1, SW1.2
VCC: JP7.7, P-JMP.1, SW1.3 (O), VCC.2

Notes on the sheet:
Motor Disable
5V Power
H-Bridge

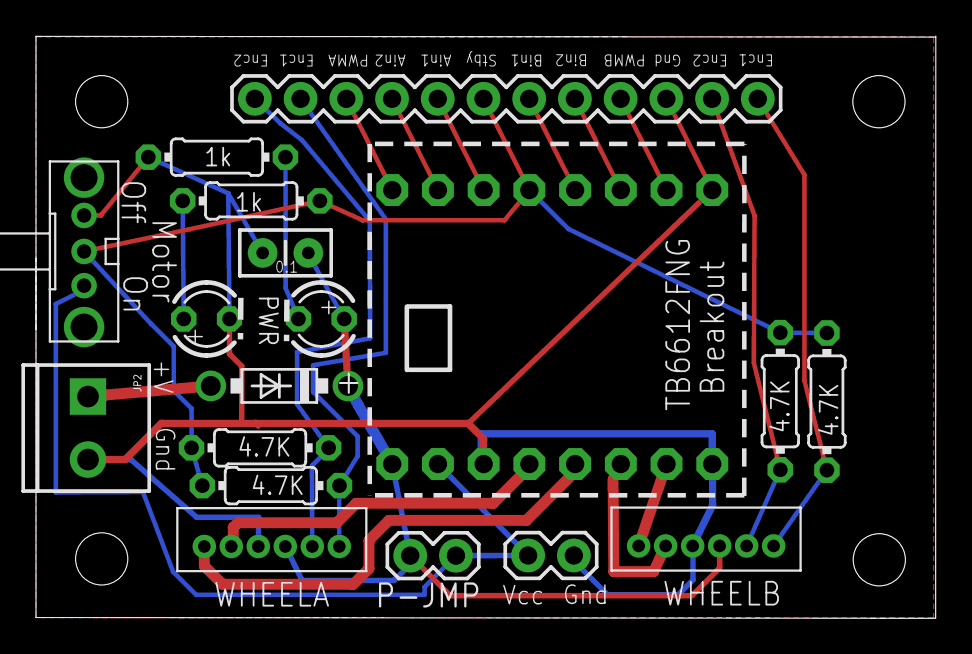
[picture p78: board Hotec_H-bridge.brd from above]

Board: 2 copper layers, 50.0 x 32.4 mm, 19 parts (0 on the bottom side), 21 nets.
