michaelmargolis/MirtoDesignFiles/Mirto_MyRIO/PCB/Mirtle_myRIO _rev2.brd

## EAGLE design Mirto_MyRIO/PCB/Mirtle_myRIO _rev2.brd (2017-03-19)

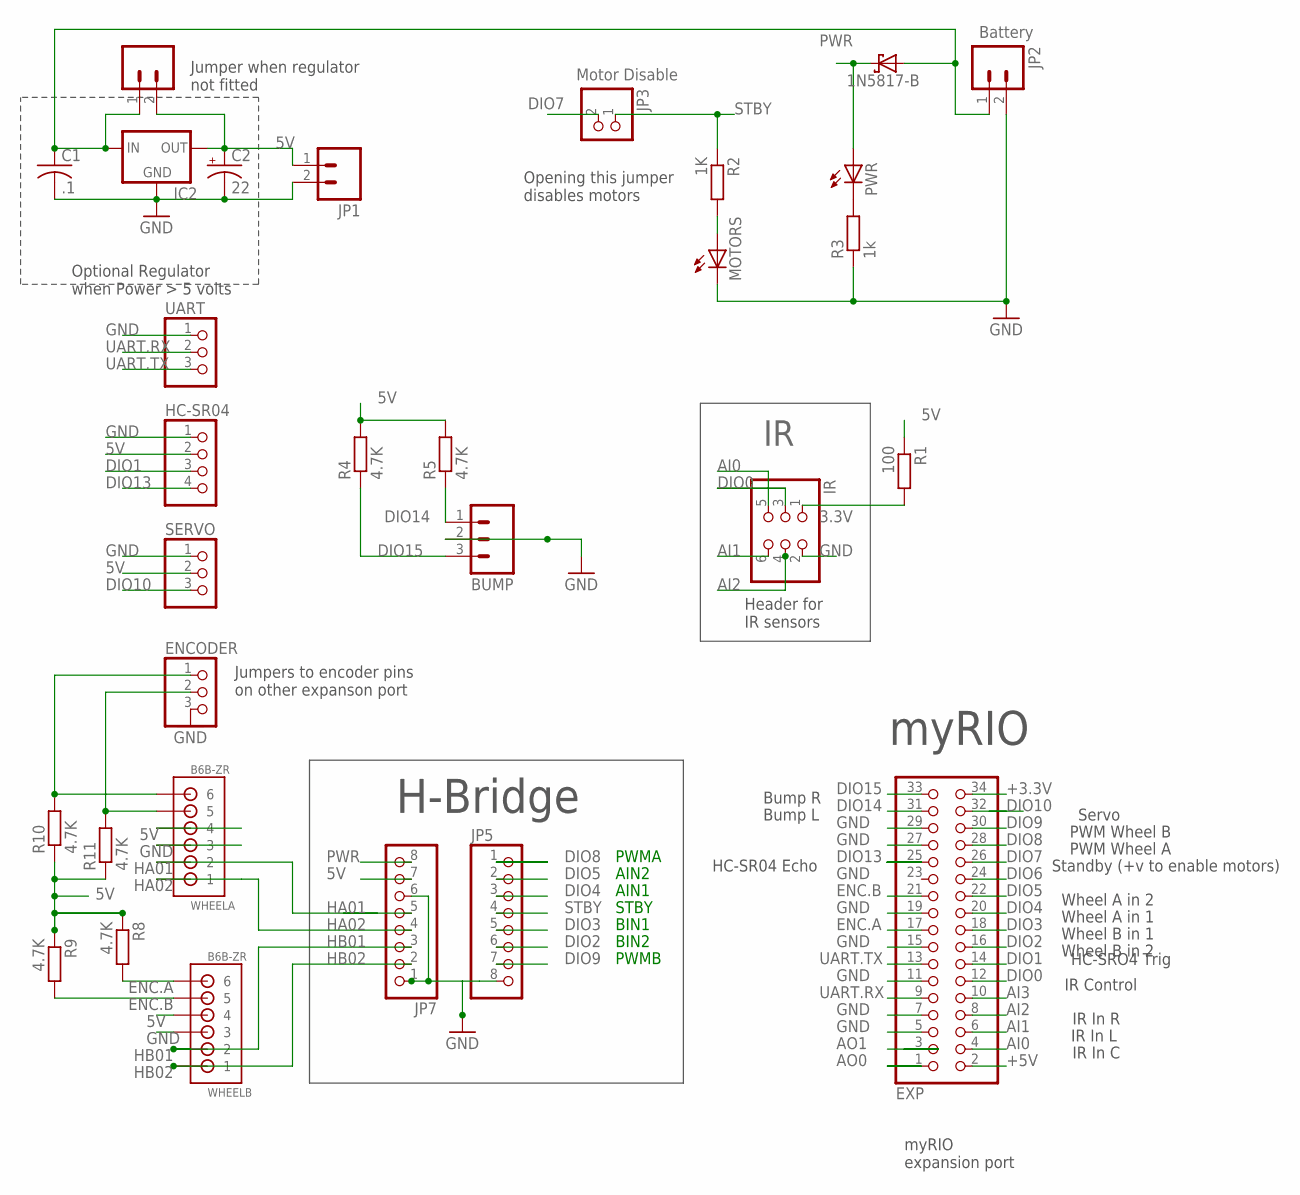
[picture p79: schematic Mirtle_myRIO _rev2.sch]

Parts:
5VJMPR: M02PTH; 1X02
BUMP: M03SCREW; SCREWTERMINAL-3.5MM-3
C1: .1; C025-024X044
C2: 22; E2-5
D1: 1N5817-B; DO41-7.6
ENCODER: PINHD-1X3/90; 1X03/90
EXP: PINHD-2X17/90; 2X17/90
HC-SR04: PINHD-1X4/90; 1X04/90
IC2: 78MXXS
IR: PINHD-2X3; 2X03
JP1, JP2: M023.5MM; SCREWTERMINAL-3.5MM-2
JP3: PINHD-1X2/90; 1X02/90
JP5, JP7: PINHD-1X8CLEANBIG; 1X08-CLEANBIG
MOTORS: LED3MM
PWR: LED3MM
R1: 100; 0204/7
R2: 1K; 0204/7
R3: 1k; 0204/7
R4, R5, R8, R9, R10, R11: 4.7K; 0204/7
SERVO: PINHD-1X3/90; 1X03/90
UART: PINHD-1X3/90; 1X03/90
WHEELA: B6B-ZR
WHEELB: B6B-ZR

Connections:
3.3V: IR.1, R1.2
5V: 5VJMPR.2, C2.+, HC-SR04.2, IC2.OUT, JP1.1, JP7.7, R1.1, R4.2, R5.2, R8.1, R9.1, R10.1, R11.1, SERVO.2, WHEELA.4, WHEELB.4
+3.3V: EXP.34
+5V: EXP.2
AI0: EXP.4, IR.5
AI1: EXP.6, IR.6
AI2: EXP.8, IR.4
AI3: EXP.10
AO0: EXP.1
AO1: EXP.3
BAT+V: 5VJMPR.1, C1.1, D1.A, IC2.IN, JP2.1
D31: ENCODER.1, R10.2, WHEELA.6
DIO0: EXP.12, IR.3
DIO1: EXP.14, HC-SR04.3
DIO2: EXP.16, JP5.6
DIO3: EXP.18, JP5.5
DIO4: EXP.20, JP5.3
DIO5: EXP.22, JP5.2
DIO6: EXP.24
DIO7: EXP.26, JP3.2
DIO8: EXP.28, JP5.1
DIO9: EXP.30, JP5.7
DIO10: EXP.32, SERVO.3
DIO13: EXP.25, HC-SR04.4
DIO14: BUMP.1, EXP.31, R5.1
DIO15: BUMP.3, EXP.33, R4.1
ENC.A: EXP.17, R8.2, WHEELB.6
ENC.B: EXP.21, R9.2, WHEELB.5
GND: BUMP.2, C1.2, C2.-, ENCODER.3, EXP.5, EXP.7, EXP.11, EXP.15, EXP.19, EXP.27, EXP.29, HC-SR04.1, IC2.GND, IR.2, JP1.2, JP2.2, JP5.8, JP7.1, JP7.6, MOTORS.K (C), R3.1, SERVO.1, UART.1, WHEELA.3, WHEELB.3
HA01: JP7.5, WHEELA.2
HA02: JP7.4, WHEELA.1
HB01: JP7.3, WHEELB.2
HB02: JP7.2, WHEELB.1
unnamed: PWR.K (C), R3.2
unnamed: ENCODER.2, R11.2, WHEELA.5
unnamed: MOTORS.A, R2.2
PWR: D1.C, JP7.8, PWR.A
STBY: JP3.1, JP5.4, R2.1
UART.RX: EXP.9, UART.2
UART.TX: EXP.13, UART.3

Notes on the sheet:
Motor Disable
Battery
Header for IR sensors
H-Bridge
myRIO
Jumpers to encoder pins on other expanson port
STBY
myRIO expansion port
AIN1
AIN2
PWMA
BIN1
BIN2
PWMB
IR In L
IR Control
Bump L
IR In C
IR In R
Bump R
HC-SR04 Echo
PWM Wheel A
PWM Wheel B
Wheel B in 1
Wheel B in 2
Wheel A in 1
Wheel A in 2
Servo
HC-SRO4 Trig
Standby (+v to enable motors)
Optional Regulator when Power > 5 volts
Jumper when regulator not fitted
Opening this jumper disables motors

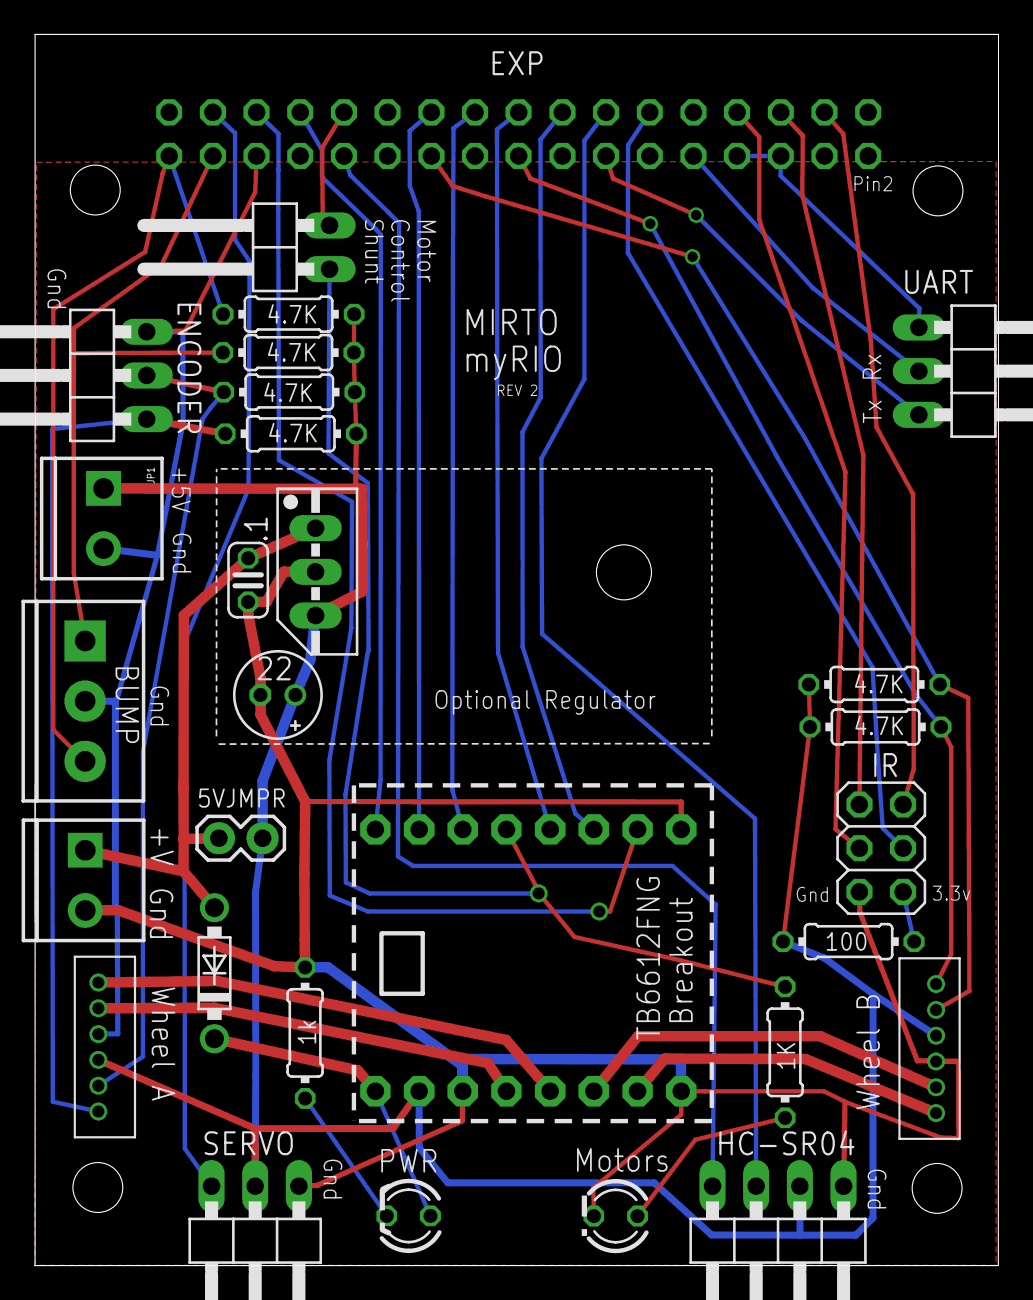
[picture p80: board Mirtle_myRIO _rev2.brd from above]

Board: 4 copper layers, 56.1 x 71.6 mm, 30 parts (1 on the bottom side), 34 nets.
