michaelmargolis/MirtoDesignFiles/Mirto_Hotec/PCB/Mirtle_Teensy3_ESP_2016_Hotec6c.brd

## EAGLE design Mirto_Hotec/PCB/Mirtle_Teensy3_ESP_2016_Hotec6c.brd (2017-03-19)

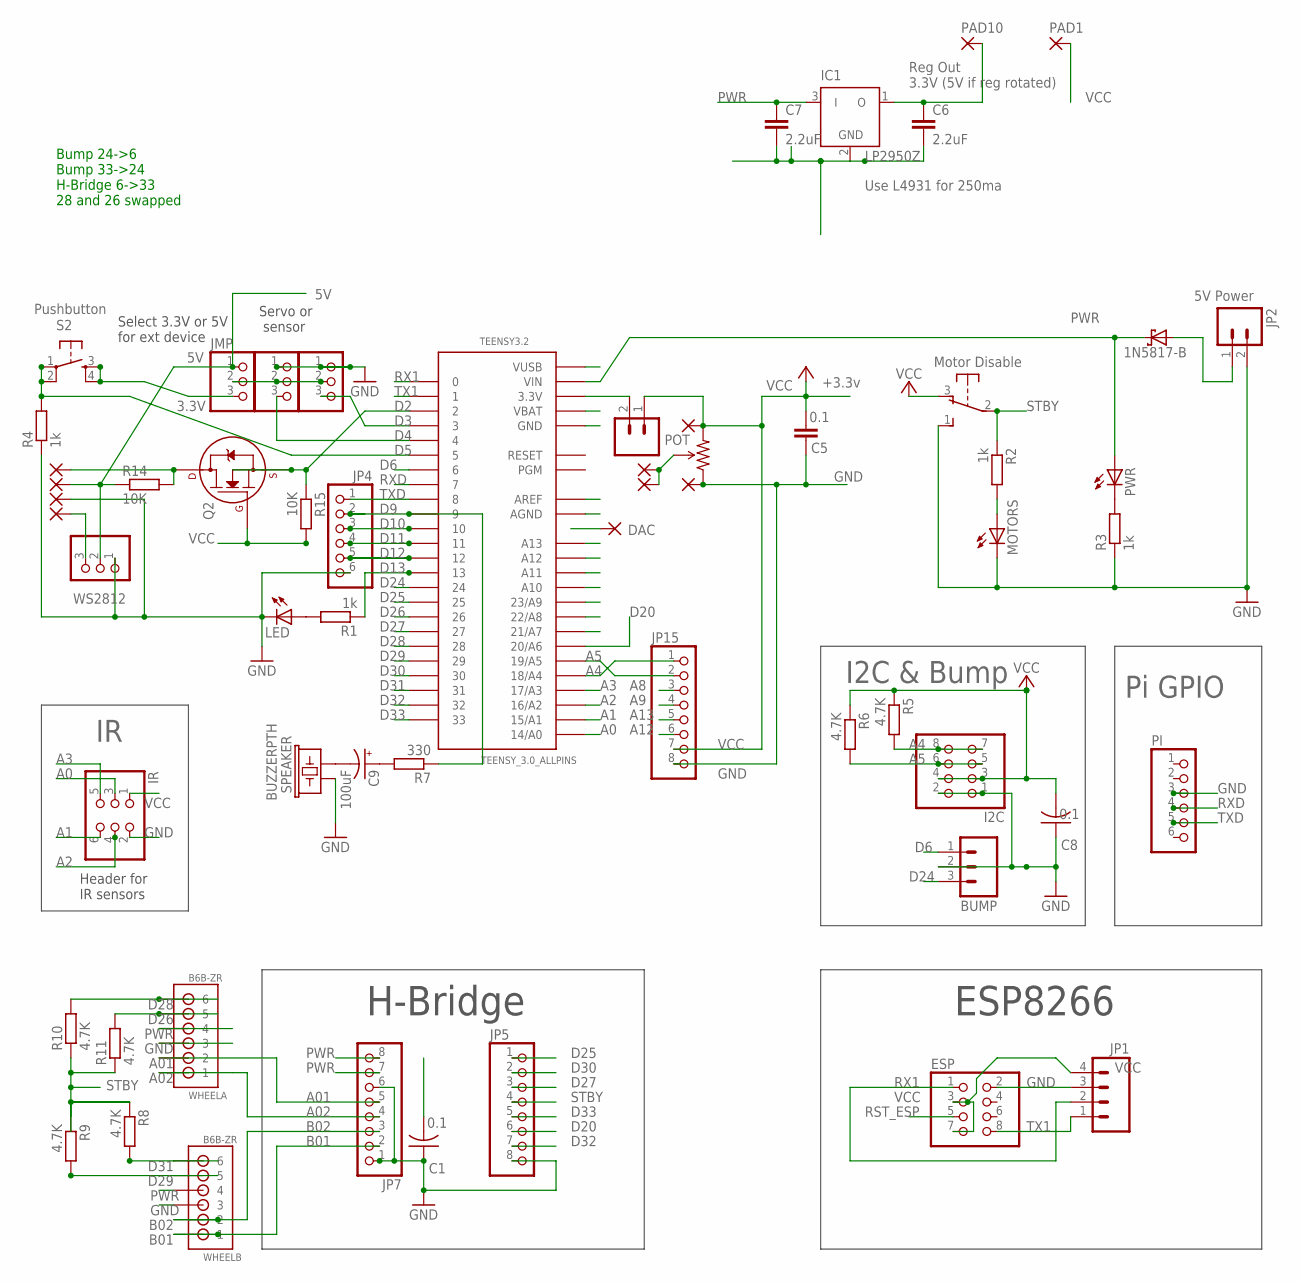
[picture p81: schematic Mirtle_Teensy3_ESP_2016_Hotec6c.sch]

Parts:
3V3: M02PTH; 1X02
BUMP: M03SCREW; SCREWTERMINAL-3.5MM-3
C1, C8: 0.1; C025-024X044
C5: 0.1; CAP-PTH-SMALLEZ
C6, C7: 2.2uF; C050-024X044
C9: 100uF; E2,5-5
D1: 1N5817-B; DO41-7.6
DAC: 1,6/0,8
ESP: PINHD-2X4; 2X04
EXT, EXT1: PINHD-1X3; 1X03
I2C: PINHD-2X4; 2X04
IC1: LP2950Z; TO92
IR: PINHD-2X3; 2X03
JMP: PINHD-1X3; 1X03
JP1: M04PTH; 1X04
JP2: M023.5MM; SCREWTERMINAL-3.5MM-2
JP4: PINHD-1X6B; 1X06-BIG
JP5, JP7: PINHD-1X8CLEANBIG; 1X08-CLEANBIG
JP15: PINHD-1X8BIG; 1X08-BIG
LED: LED3MM
MOTORS: LED3MM
PAD1, PAD2, PAD3, PAD4, PAD5, PAD6, PAD7, PAD8, PAD9, PAD10: 1,6/0,8
PI: PINHD-1X6; 1X06
POT: TSR-3386; 3386U
PWR: LED3MM
Q2: 2N7000_TO92; TO-92
R1, R2, R3, R4: 1k; 0204/7
R5, R6: 4.7K; 0204/7
R7: 330; 0204/7
R8, R9, R10, R11: 4.7K; 0204/5
R14, R15: 10K; 0204/5
S2: TAC_SWITCHPTH; TACTILE-PTH
SPEAKER: BUZZERPTH; BUZZER-12MM
SW1: OS102011MA1Q
TEENSY3.2: TEENSY_3.0_ALLPINS
WHEELA: B6B-ZR
WHEELB: B6B-ZR
WS2812: PINHD-1X3; 1X03

Connections:
2N700: PAD2.1, Q2.3 (D), R14.2
5VIN: C1.2, D1.A, JP2.1
A0: IR.3, TEENSY3.2.14/A0
A1: IR.6, TEENSY3.2.15/A1
A01: JP7.5, WHEELA.2
A2: IR.4, TEENSY3.2.16/A2
A02: JP7.4, WHEELA.1
A3: IR.5, TEENSY3.2.17/A3
A4: I2C.7, I2C.8, JP15.1, R5.2, TEENSY3.2.18/A4
A5: I2C.5, I2C.6, JP15.2, R6.2, TEENSY3.2.19/A5
A7: PAD6.1, PAD9.1, POT.2 (WIPER), TEENSY3.2.21/A7
A8: JP15.3, TEENSY3.2.22/A8
A9: JP15.4, TEENSY3.2.23/A9
A10: TEENSY3.2.A10
A11: TEENSY3.2.A11
A12: JP15.6, TEENSY3.2.A12
A13: JP15.5, TEENSY3.2.A13
B01: JP7.2, WHEELB.1
B02: JP7.3, WHEELB.2
D2: Q2.1 (S), R15.1, TEENSY3.2.2
D3: EXT.3, TEENSY3.2.3
D4: EXT1.3, TEENSY3.2.4
D5: R4.2, S2.1, S2.2, TEENSY3.2.5
D6: BUMP.1, TEENSY3.2.6
D9: JP4.2, R7.1, TEENSY3.2.9
D10: JP4.3, TEENSY3.2.10
D11: JP4.4, TEENSY3.2.11
D12: JP4.5, TEENSY3.2.12
D13: R1.1, TEENSY3.2.13
D20: JP5.6, TEENSY3.2.20/A6
D24: BUMP.3, TEENSY3.2.24
D25: JP5.1, TEENSY3.2.25
D26: R11.2, TEENSY3.2.26, WHEELA.5
D27: JP5.3, TEENSY3.2.27
D28: R10.2, TEENSY3.2.28, WHEELA.6
D29: R9.2, TEENSY3.2.29, WHEELB.5
D30: JP5.2, TEENSY3.2.30
D31: R8.2, TEENSY3.2.31, WHEELB.6
D32: JP5.7, TEENSY3.2.32
D33: JP5.5, TEENSY3.2.33
GND: BUMP.2, C1.1, C5.1, C6.2, C7.2, C8.1, ESP.2, EXT.1, EXT1.1, I2C.1, I2C.2, IC1.2 (GND), IR.2, JP1.3, JP2.2, JP4.6, JP5.8, JP7.1, JP7.6, JP15.8, LED.K (C), MOTORS.K (C), PAD4.1, PAD8.1, PI.3, POT.1 (CCW), R3.1, R4.1, SPEAKER.+ (1), SW1.1 (S), TEENSY3.2.AGND, TEENSY3.2.GND, TEENSY3.2.GND1 (GND), TEENSY3.2.GND2 (GND), WHEELA.3, WHEELB.3, WS2812.1
unnamed: PWR.K (C), R3.2
unnamed: LED.A, R1.2
unnamed: 3V3.2, TEENSY3.2.3.3V, TEENSY3.2.3.3V1 (3.3V), TEENSY3.2.3.3V2 (3.3V)
unnamed: MOTORS.A, R2.2
unnamed: C6.1, IC1.1 (O), PAD10.1
unnamed: PAD5.1, WS2812.3
unnamed: EXT.2, EXT1.2, JMP.2
unnamed: C9.-, SPEAKER.- (2)
unnamed: C9.+, R7.2
PWR: C7.1, D1.C, IC1.3 (I), JMP.1, JP7.7, JP7.8, PAD3.1, PWR.A, R14.1, TEENSY3.2.VIN, WHEELA.4, WHEELB.4, WS2812.2
RST_ESP: ESP.5
RX1: ESP.1, JP1.2, TEENSY3.2.0
RXD: PI.4, TEENSY3.2.7
STBY: JP5.4, R2.1, R8.1, R9.1, R10.1, R11.1, SW1.2
TX1: ESP.8, JP1.1, TEENSY3.2.1
TXD: JP4.1, PI.5, TEENSY3.2.8
VCC: 3V3.1, C5.2, C8.2, ESP.3, ESP.7, I2C.3, I2C.4, IR.1, JMP.3, JP1.4, JP15.7, PAD1.1, PAD7.1, POT.3 (CW), Q2.2 (G), R5.1, R6.1, R15.2, S2.3, S2.4, SW1.3 (O)

Notes on the sheet:
Motor Disable
5V Power
+3.3v
3.3V
Servo or sensor
Select 3.3V or 5V for ext device
Header for IR sensors
Pushbutton
H-Bridge
ESP8266
Pi GPIO
I2C & Bump
Reg Out 3.3V (5V if reg rotated)
Use L4931 for 250ma
Bump 24->6 Bump 33->24 H-Bridge 6->33 28 and 26 swapped

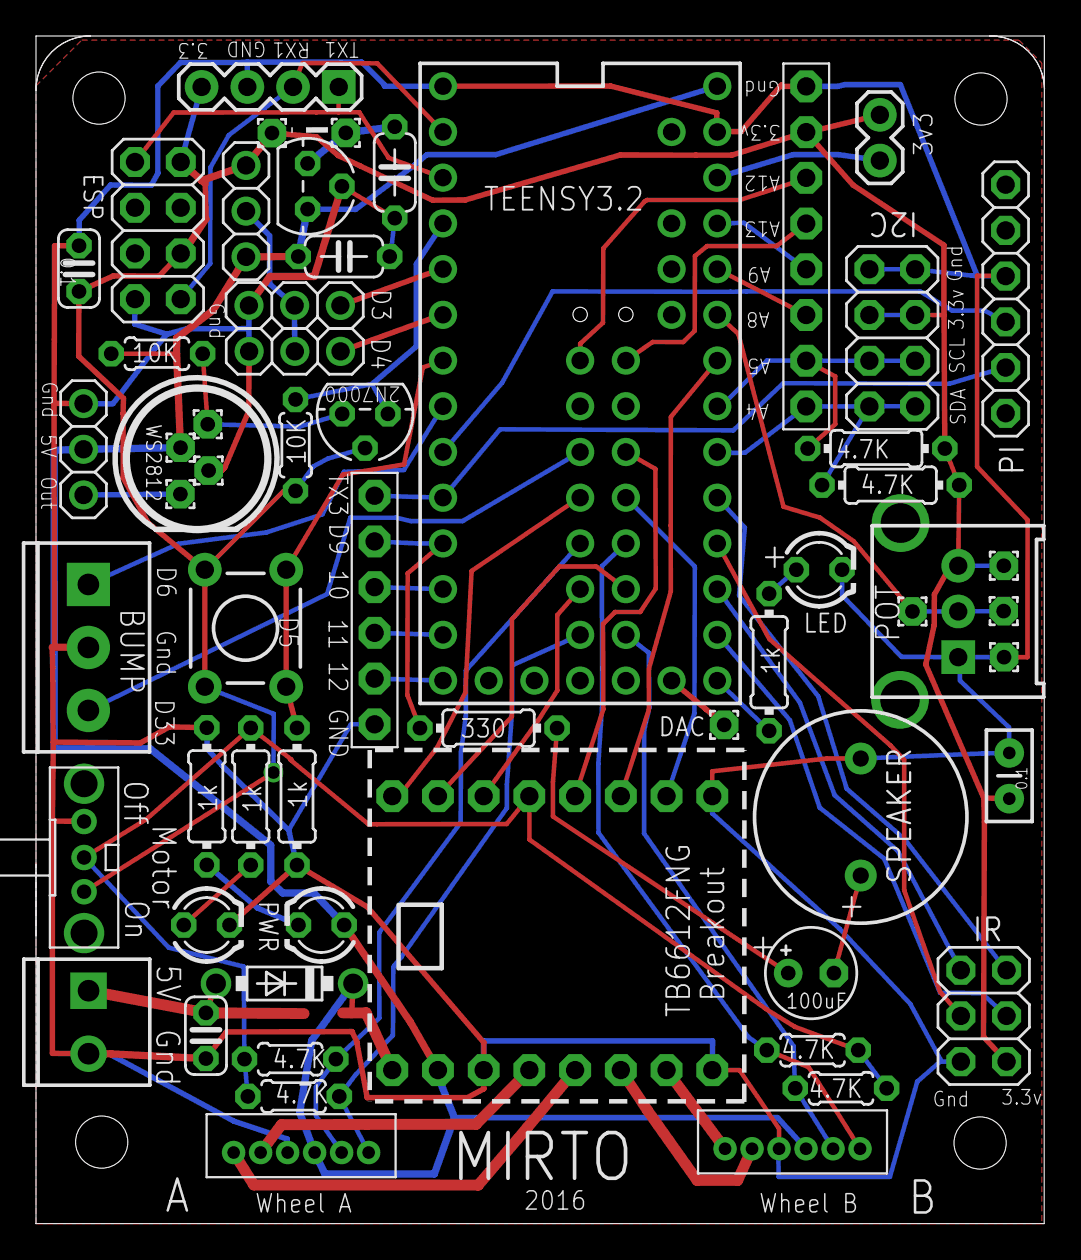
[picture p82: board Mirtle_Teensy3_ESP_2016_Hotec6c.brd from above]

Board: 2 copper layers, 56.0 x 66.0 mm, 59 parts (0 on the bottom side), 55 nets.
