michaelmargolis/MirtoDesignFiles/(commit log)

2017-03-19 updated directories
    [1_3 oled bracketTiltedSnap.stl, LineSensorAdapter.brd, LineSensorAdapter.sch, Mirtle_Teensy3_ESP_2016_Hotec6c.brd, Mirtle_Teensy3_ESP_2016_Hotec6c.sch, Mirtle_myRIO _rev2.brd, Mirtle_myRIO _rev2.sch, MirtoAcrylicChassis_6_off_ FullSheet.dxf]
2017-03-19 Added motor specs to build document
    [1_3 oled bracketTiltedSnap.stl, LineSensorAdapter.brd, LineSensorAdapter.sch, Mirtle_Teensy3_ESP_2016_Hotec6c.brd, Mirtle_Teensy3_ESP_2016_Hotec6c.sch, Mirtle_myRIO _rev2.brd, Mirtle_myRIO _rev2.sch, MirtoAcrylicChassis_6_off_ FullSheet.dxf]
2017-03-20 Added info on H-bridge stand-alone board
    [Hotec_H-bridge.brd, Hotec_H-bridge.sch]
2018-03-24 Initial commit of Arduino test sketch for Mirto 2016 PCB
